andrewgond/DIY-Oscilliscope/Documentation/Oscilloscope_project_presentation.pdf

# Portable And Lightweight Oscilloscope

# Group 6: Andrew Gondoputro, Luka Radovic, Gavin Le

# Project Summary

- Designed a portable, dual-channel digital oscilloscope - Supports ±10 V analog inputs and 200 kHz sampling per channel - Built around a Teensy 4.1 with a fully custom analog front end (AFE) - Real-time signal display on onboard LCD (no PC required) - Single rotary encoder/button used for all user interaction (pause, trigger, scale) - Main goals: Low-cost, portable, standalone oscilloscope for student/lab use - Challenges included: - Conditioning ±10 V signals to 0–3.3 V ADC range - Achieving stable ADC performance - Integrating all blocks into a clean enclosure

### Achievements: Verified performance, clean interface

# Analog Front End

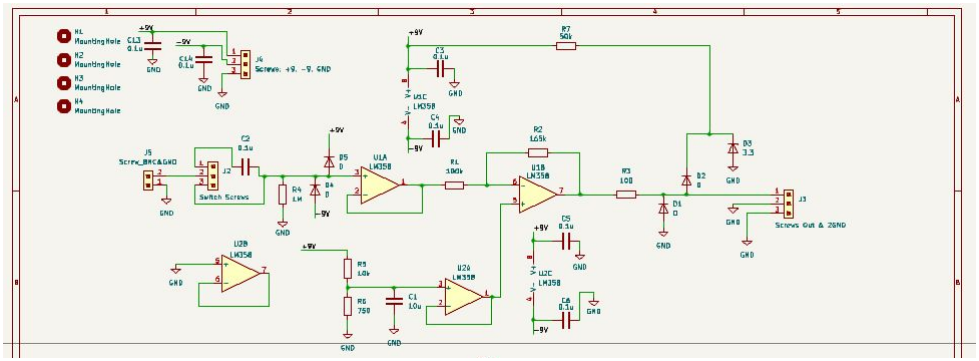
[picture p1: figure]

# Power Block/Supply and User Interface/Display

## Gavin Le

# Power Block/Supply

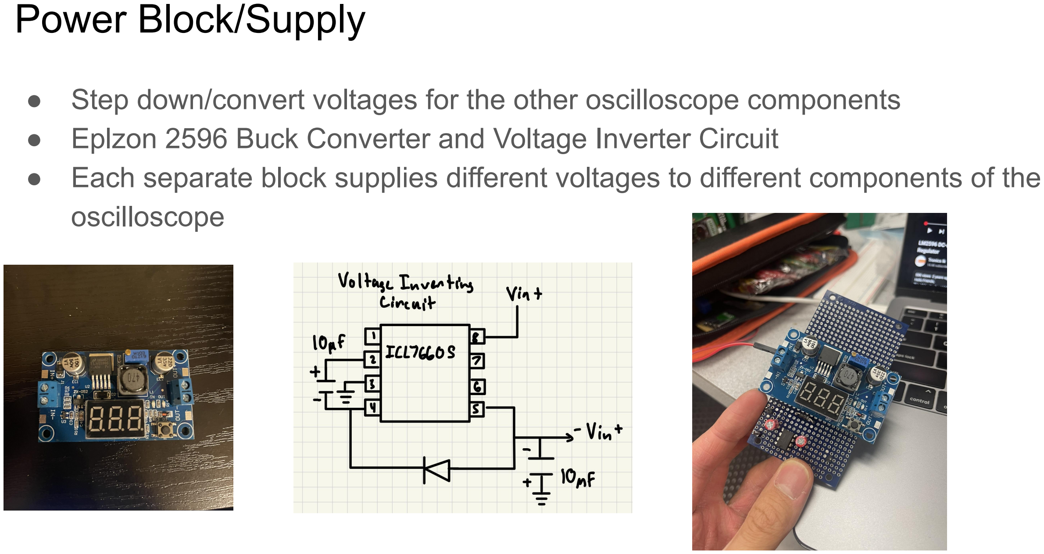
[picture p2: page 5]

## - Step down/convert voltages for the other oscilloscope components - Eplzon 2596 Buck Converter and Voltage Inverter Circuit - Each separate block supplies different voltages to different components of the oscilloscope

# Diagram

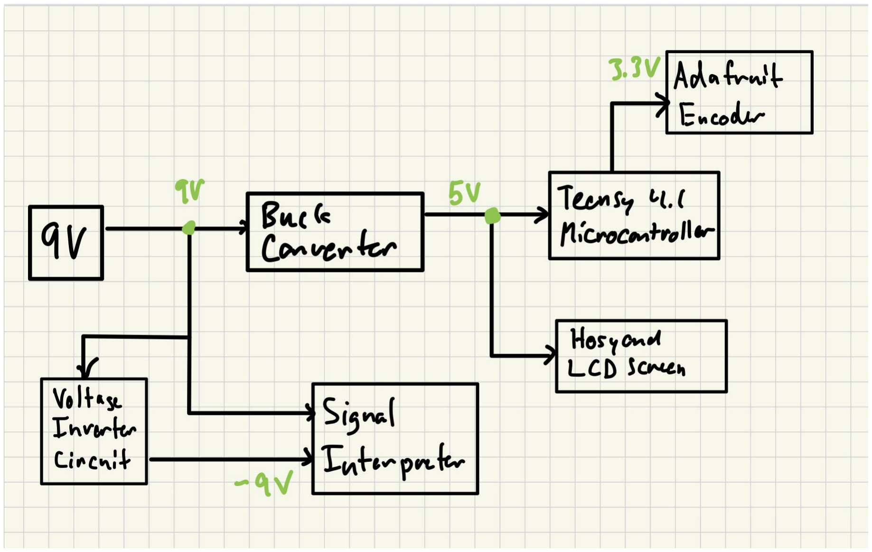
[picture p3: figure]

# User Interface/Display

## - One Adafruit I2C Stemma QT Rotary Encoder

- Acts as button and knob
- Allows for switching between channels, axes, selecting/triggering, and sweeping signals

## - Hosyond IPS Capacitive Touch Screen LCD Module

- Displays time and voltage axes, as well as electric signal

## - Teensy 4.1 Microcontroller

- Handles the code and functions of the oscilloscope
- Acts as an interface bridge between the encoder and lcd screen

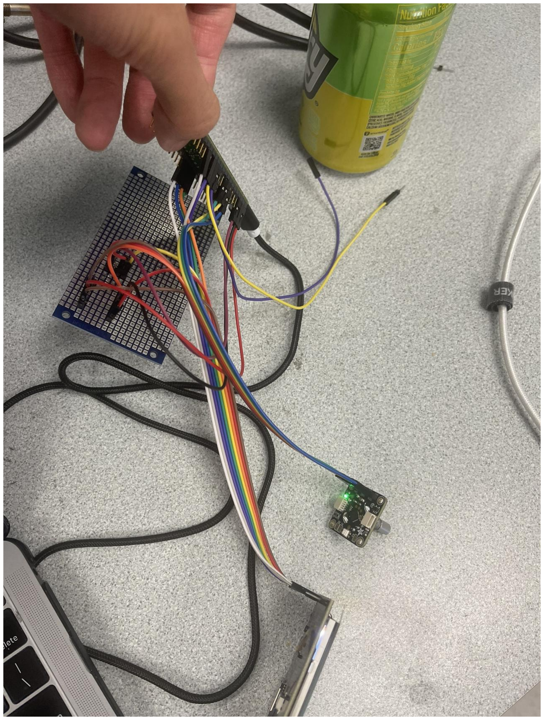
[picture p4: figure]
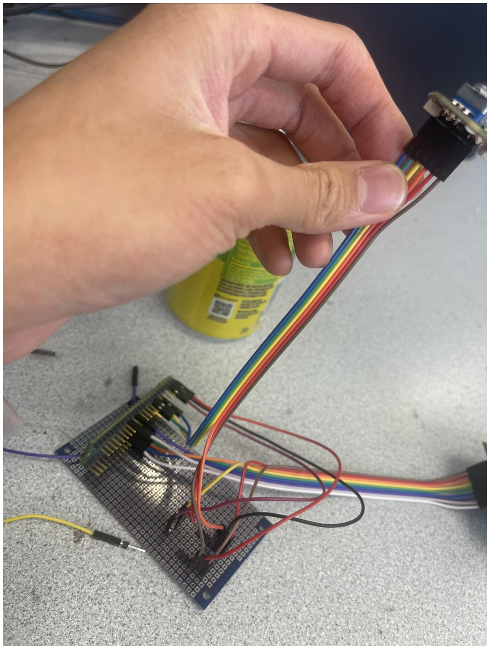
[picture p5: figure]

# Enclosure

## - Made in CAD for exact measurements -> 3D Printed in PLA Plastic - Sizing of: 3.5 x 4.5 x 7.5in - Slots for each UI component to fit properly either through tolerances or screws - Interior holding all other blocks with proper placement

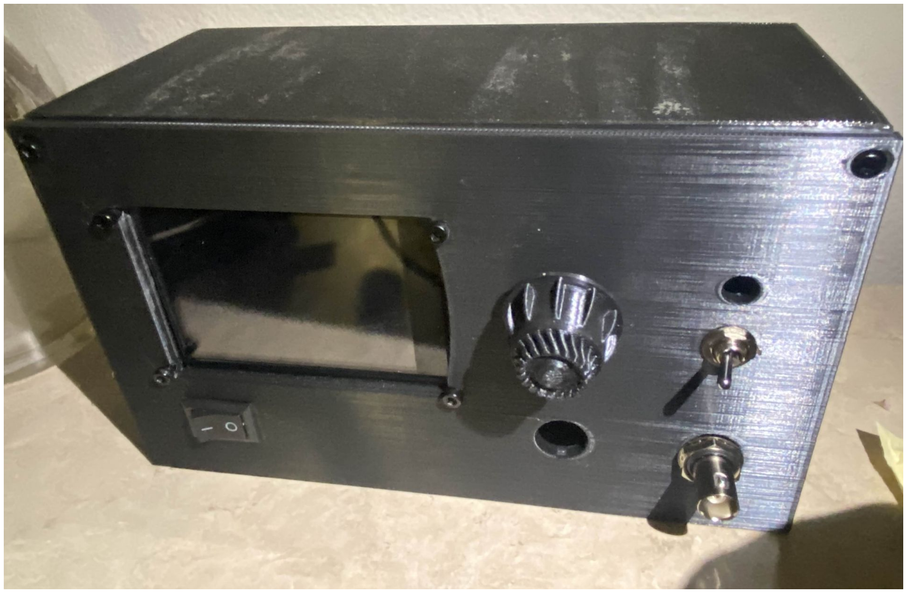
[picture p6: figure]
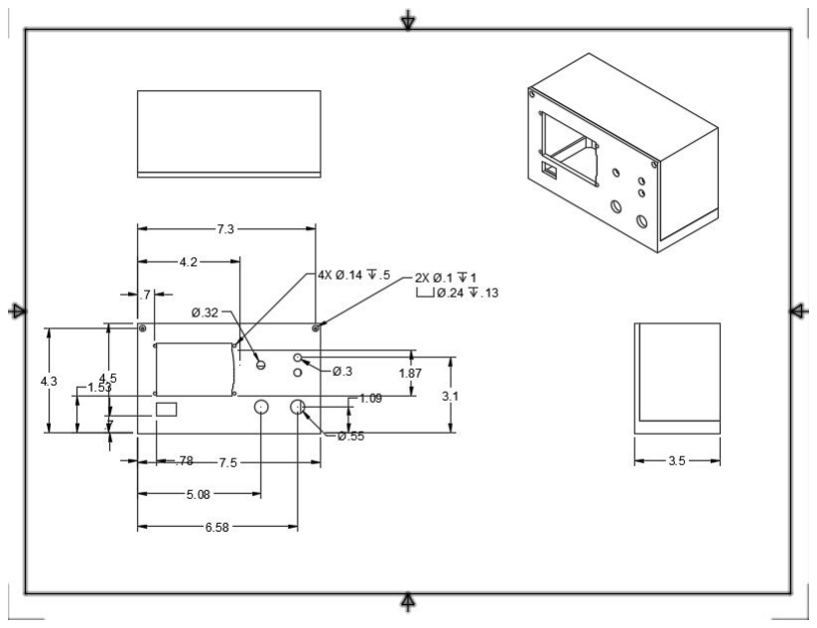
[picture p7: figure]

# Bottom Piece

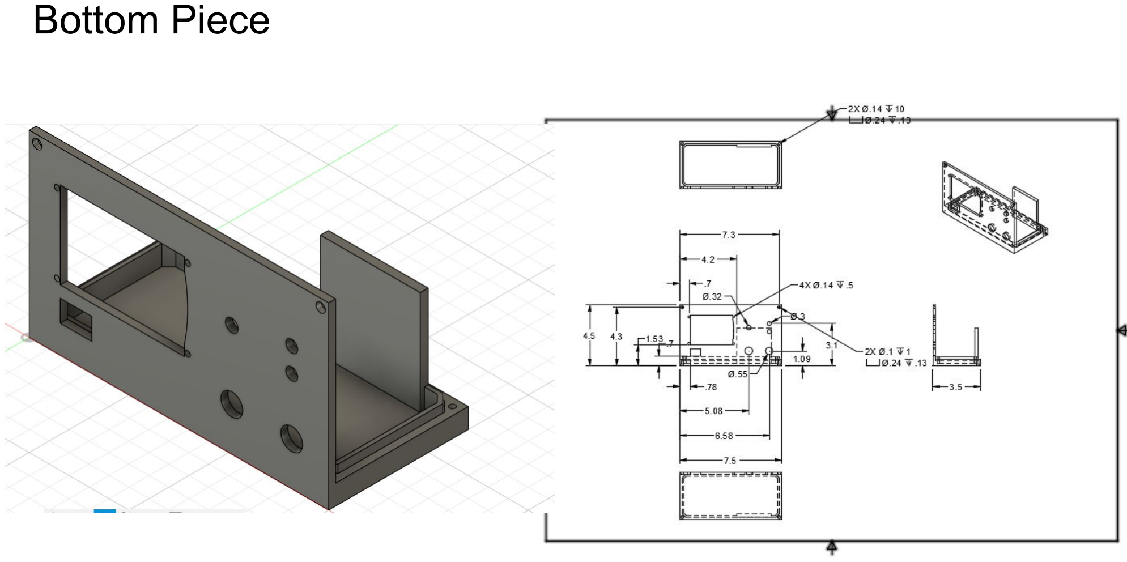
[picture p8: page 9]

# Top Piece

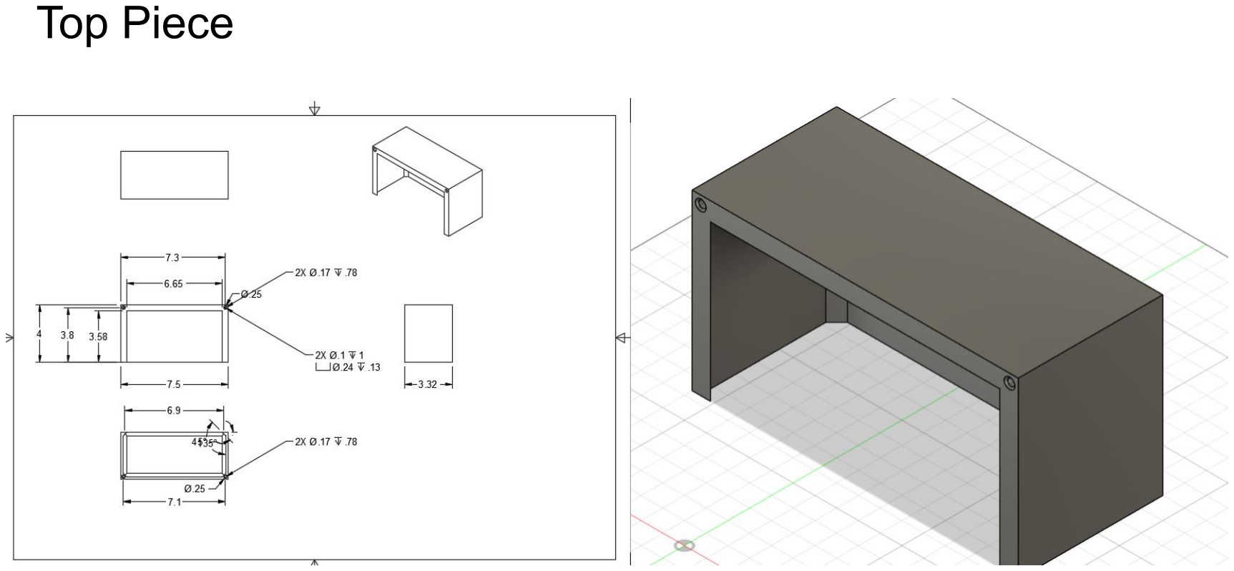
[picture p9: page 10]

# Code

## Main Parts:

## - Receiving signals from ADC to sample a high frequency

## - Receiving User Input from encoder

## - Coding a User Output on the LCD

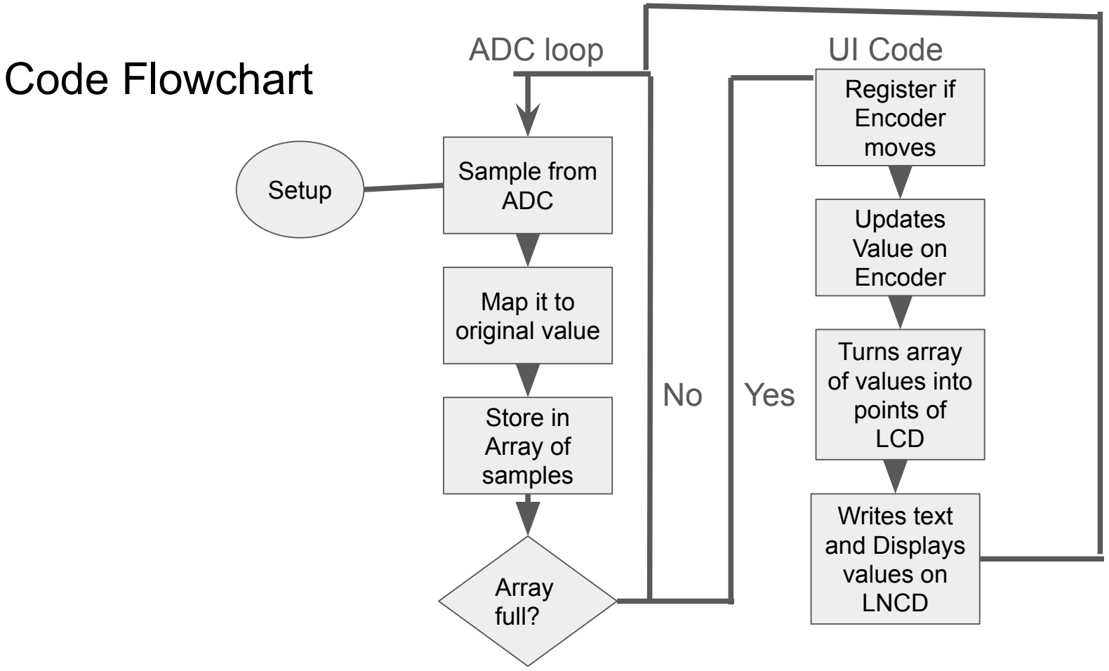
[picture p10: figure]
Code Flowchart; Setup; Sample from ADC; Map it to original value; Store in Array of samples; Array full?; ADC loop; Yes; Register if Encoder moves; Updates Value on Encoder; Turns array of values into points of LCD; Writes text and Displays values on LNCD; UI Code

# Code: Sampling

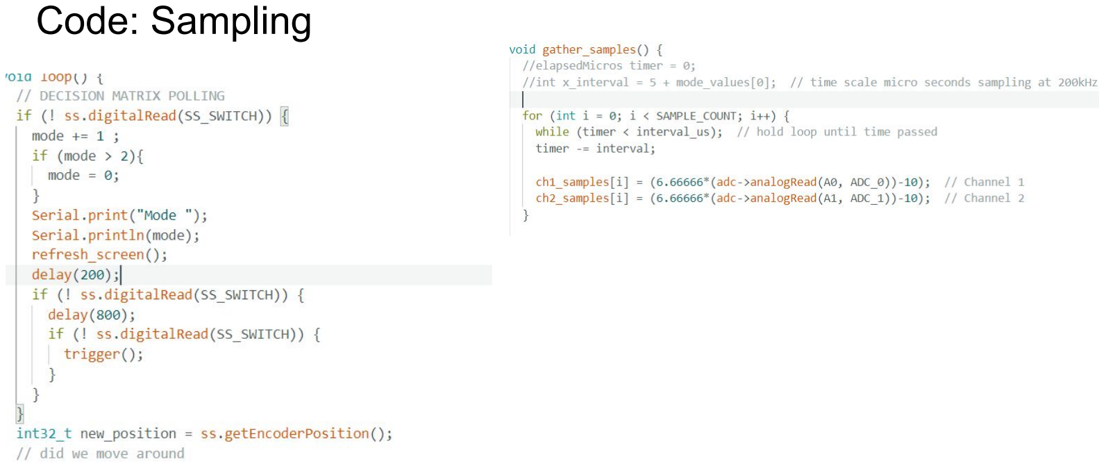
[picture p11: page 13]

# Code: User Input

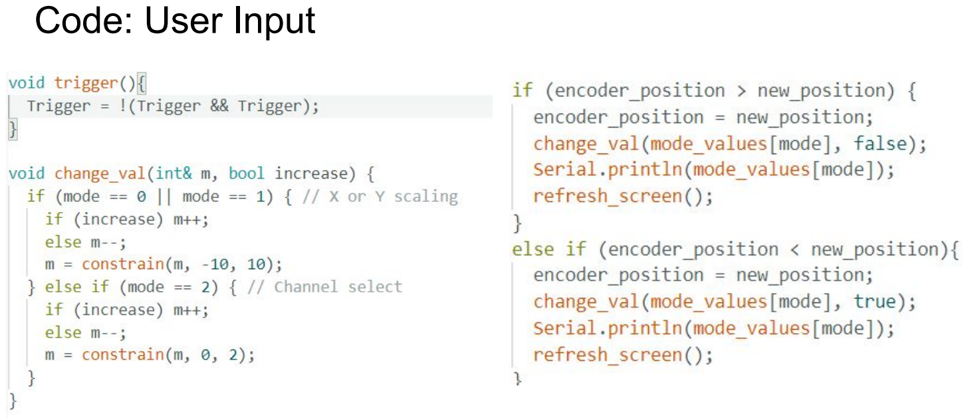
[picture p12: page 14]

# Code: User Output

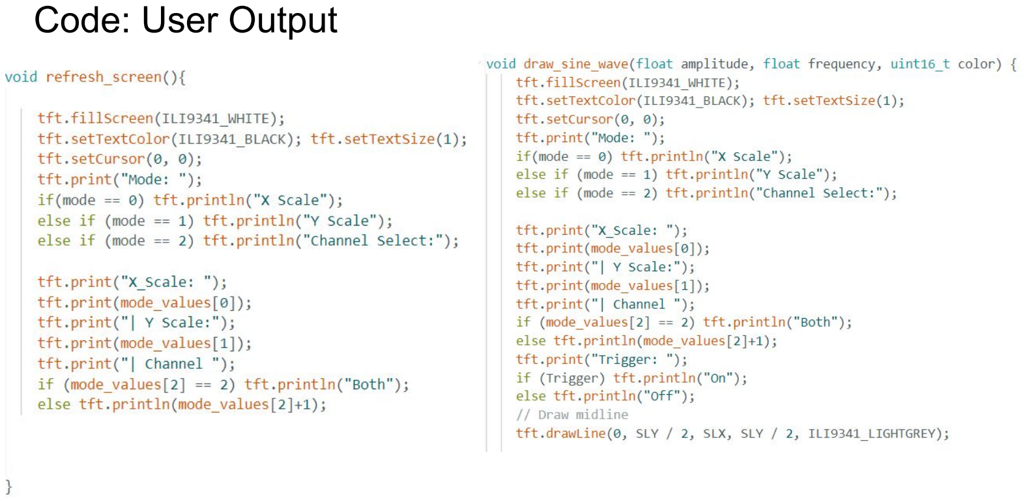
[picture p13: page 15]

# Closing

Achieved:

- Safe ±10 V input range
- 200 kHz sampling per channel
- Real-time LCD display with intuitive control
- Fully modular and battery-powered design

Built completely from scratch with protoboards, firmware, and 3D printing Future improvements:

- Custom PCB for better layout and durability
- Higher-resolution display or waveform features (e.g., FFT mode)
- Expansion to 4+ channels or wireless display integration

Demonstrated that lab-grade tools can be made compact, affordable, and user-friendly
