andrewgond/DIY-Oscilliscope/Osilloscope-BOM.pdf

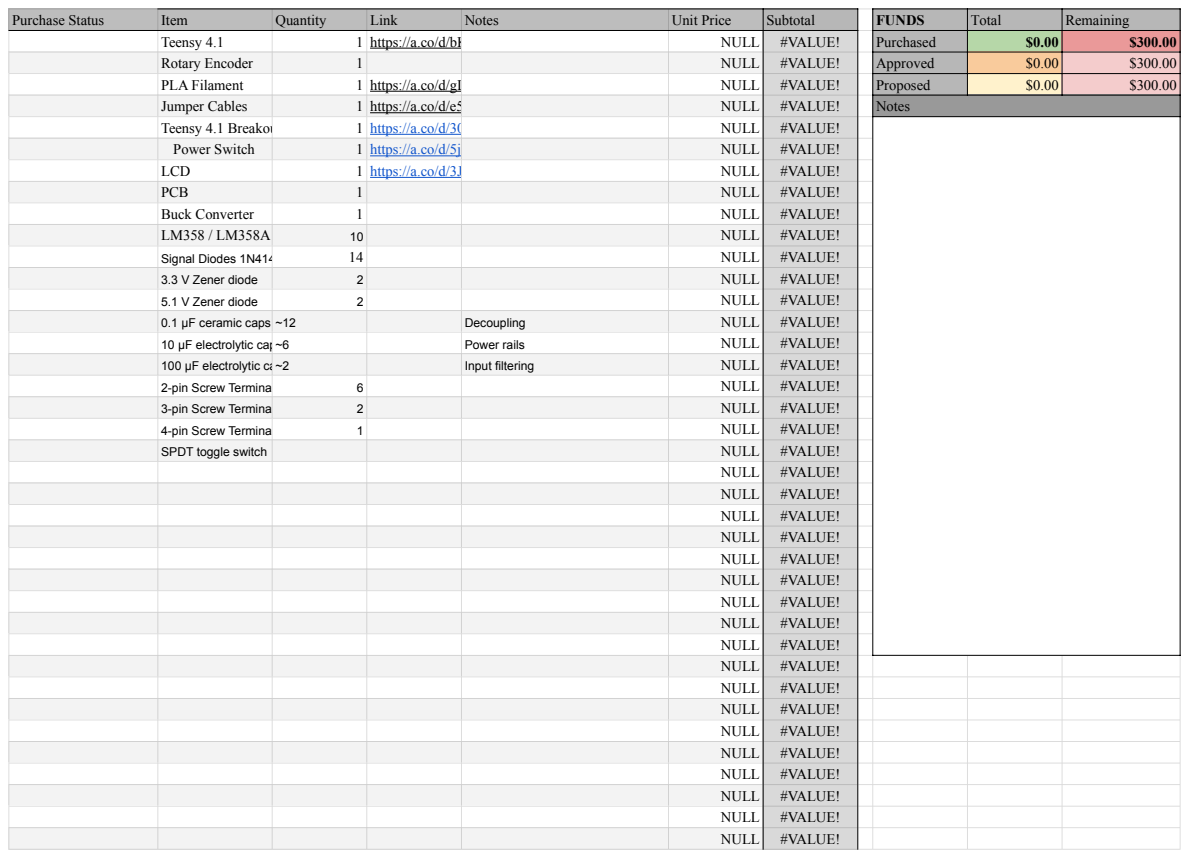
[picture p14: page 1]
Purchase Status; Item; Quantity; Link; Notes; Unit Price; Subtotal; FUNDS; Total; Remaining; Teensy 4.1; 1 https://a.co/d/bKC4gqg; NULL; #VALUE!; Purchased; Rotary Encoder; Approved; PLA Filament; 1 https://a.co/d/gLLok2z; Proposed; Jumper Cables; 1 https://a.co/d/e5Bf7xR; Teensy 4.1 Breakout Board; 1 https://a.co/d/30mFnx3; Power Switch; 1 https://a.co/d/5jJEjIV; LCD; 1 https://a.co/d/3JnT9iV; PCB; Buck Converter; LM358 / LM358A / LM358B dual op-amp 10; Signal Diodes 1N4148; 3.3 V Zener diode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

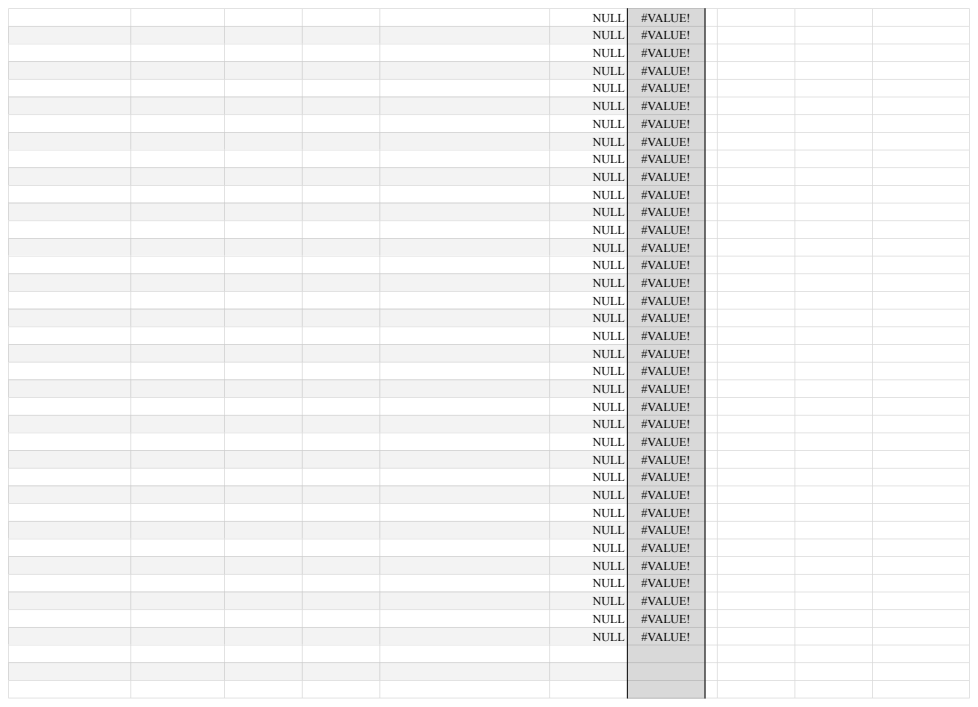
[picture p15: page 2]

NULL | #VALUE!

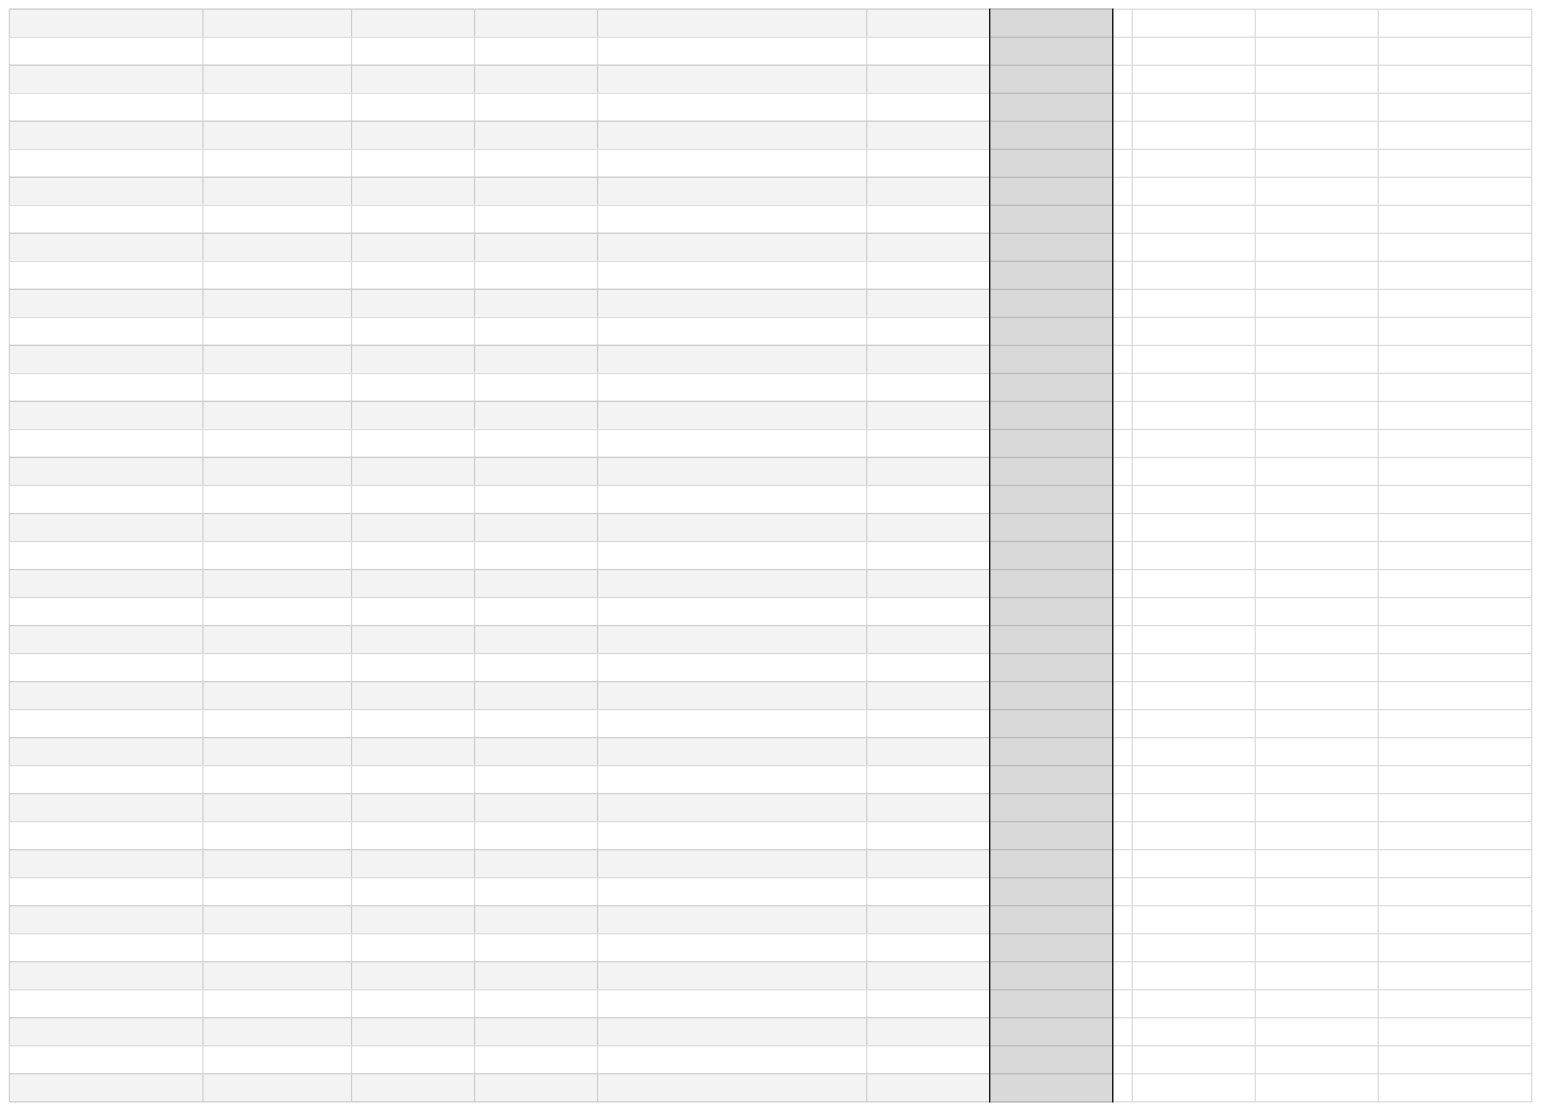
[picture p16: page 3]

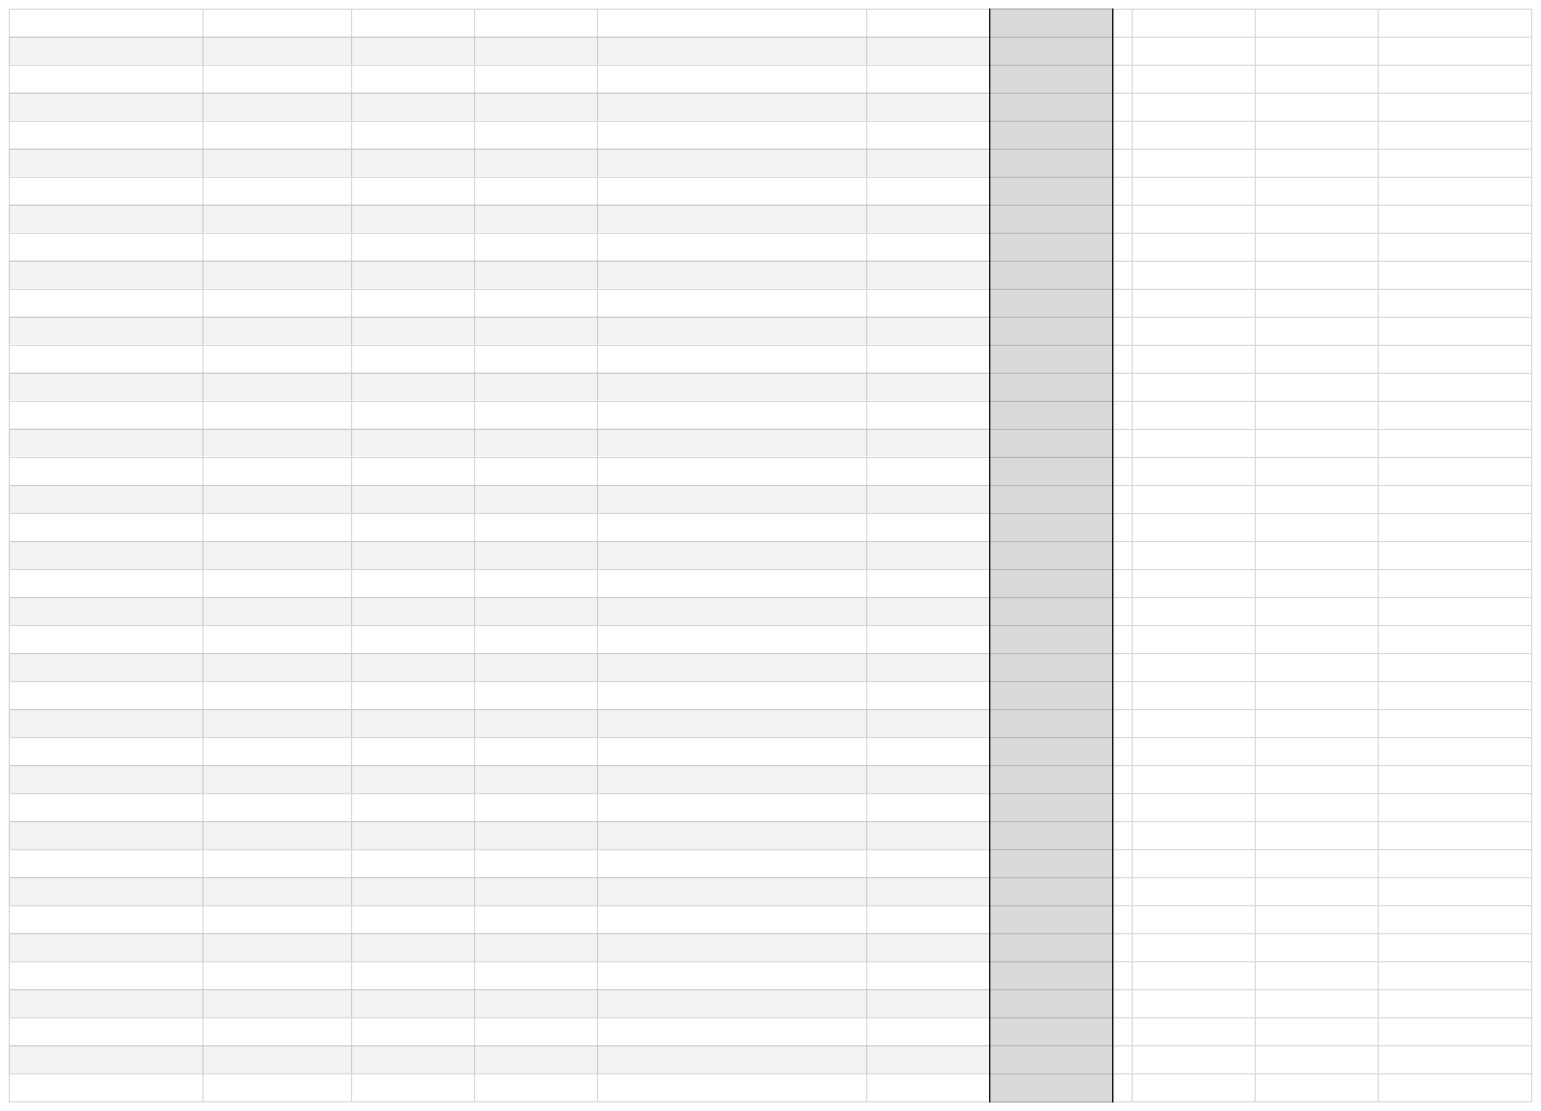
[picture p17: page 4]

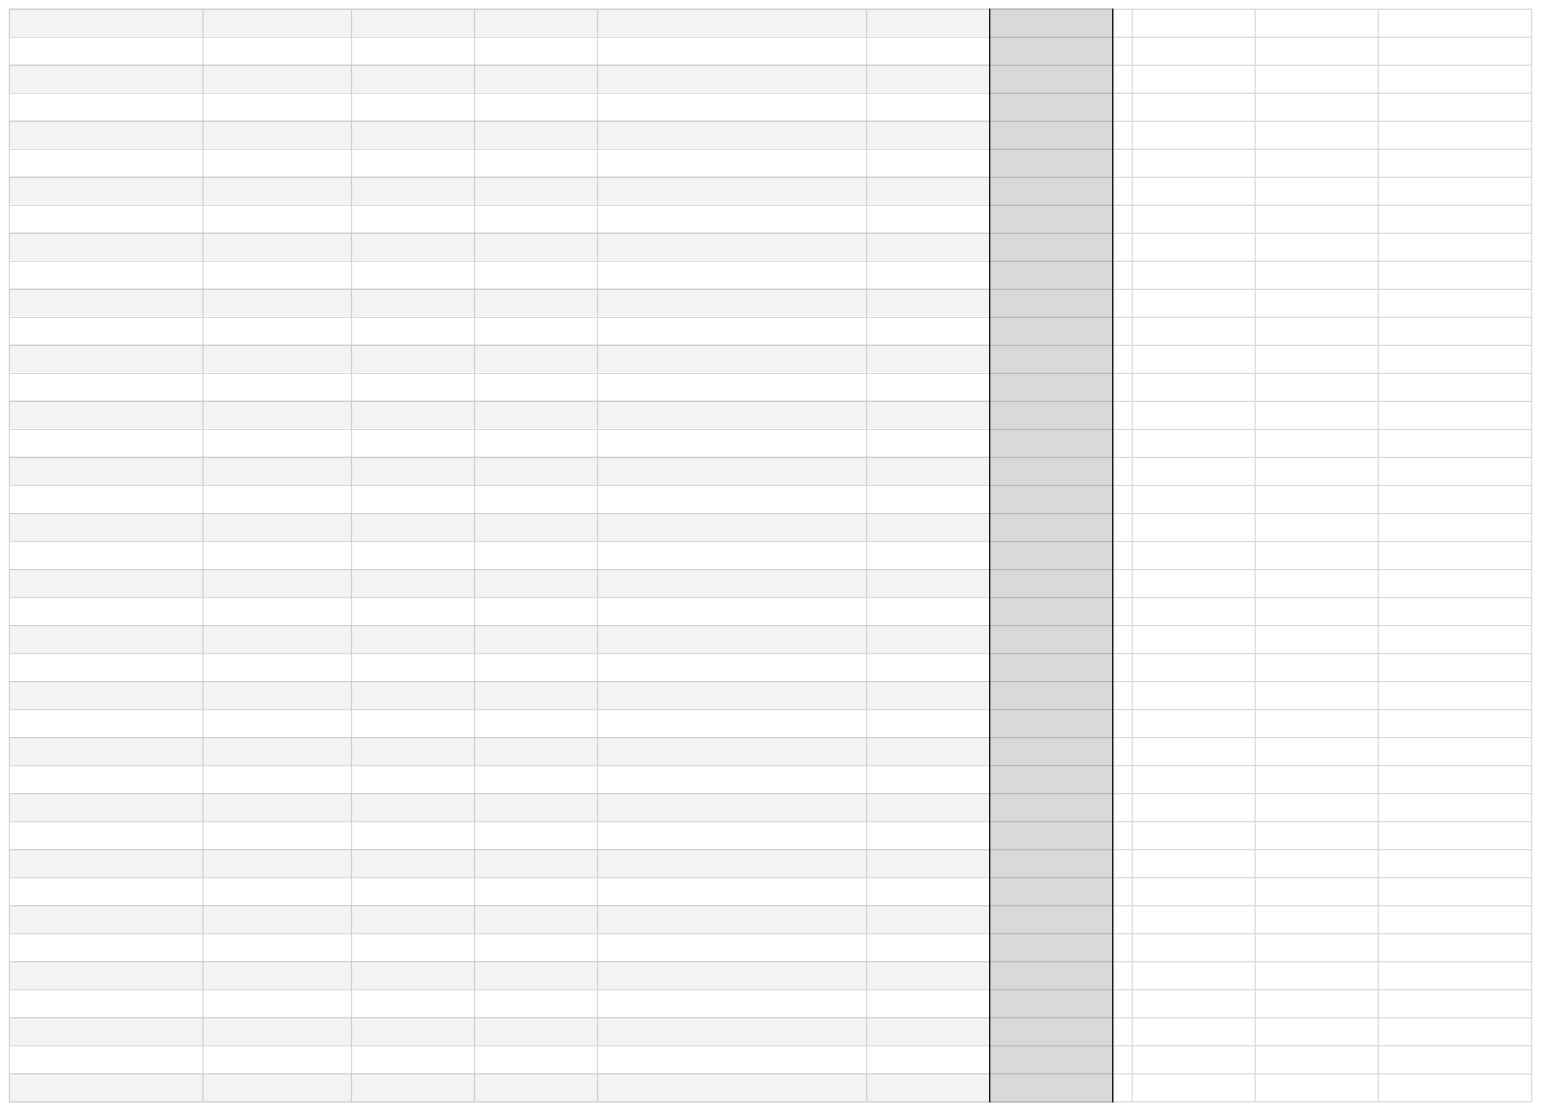
[picture p18: page 9]

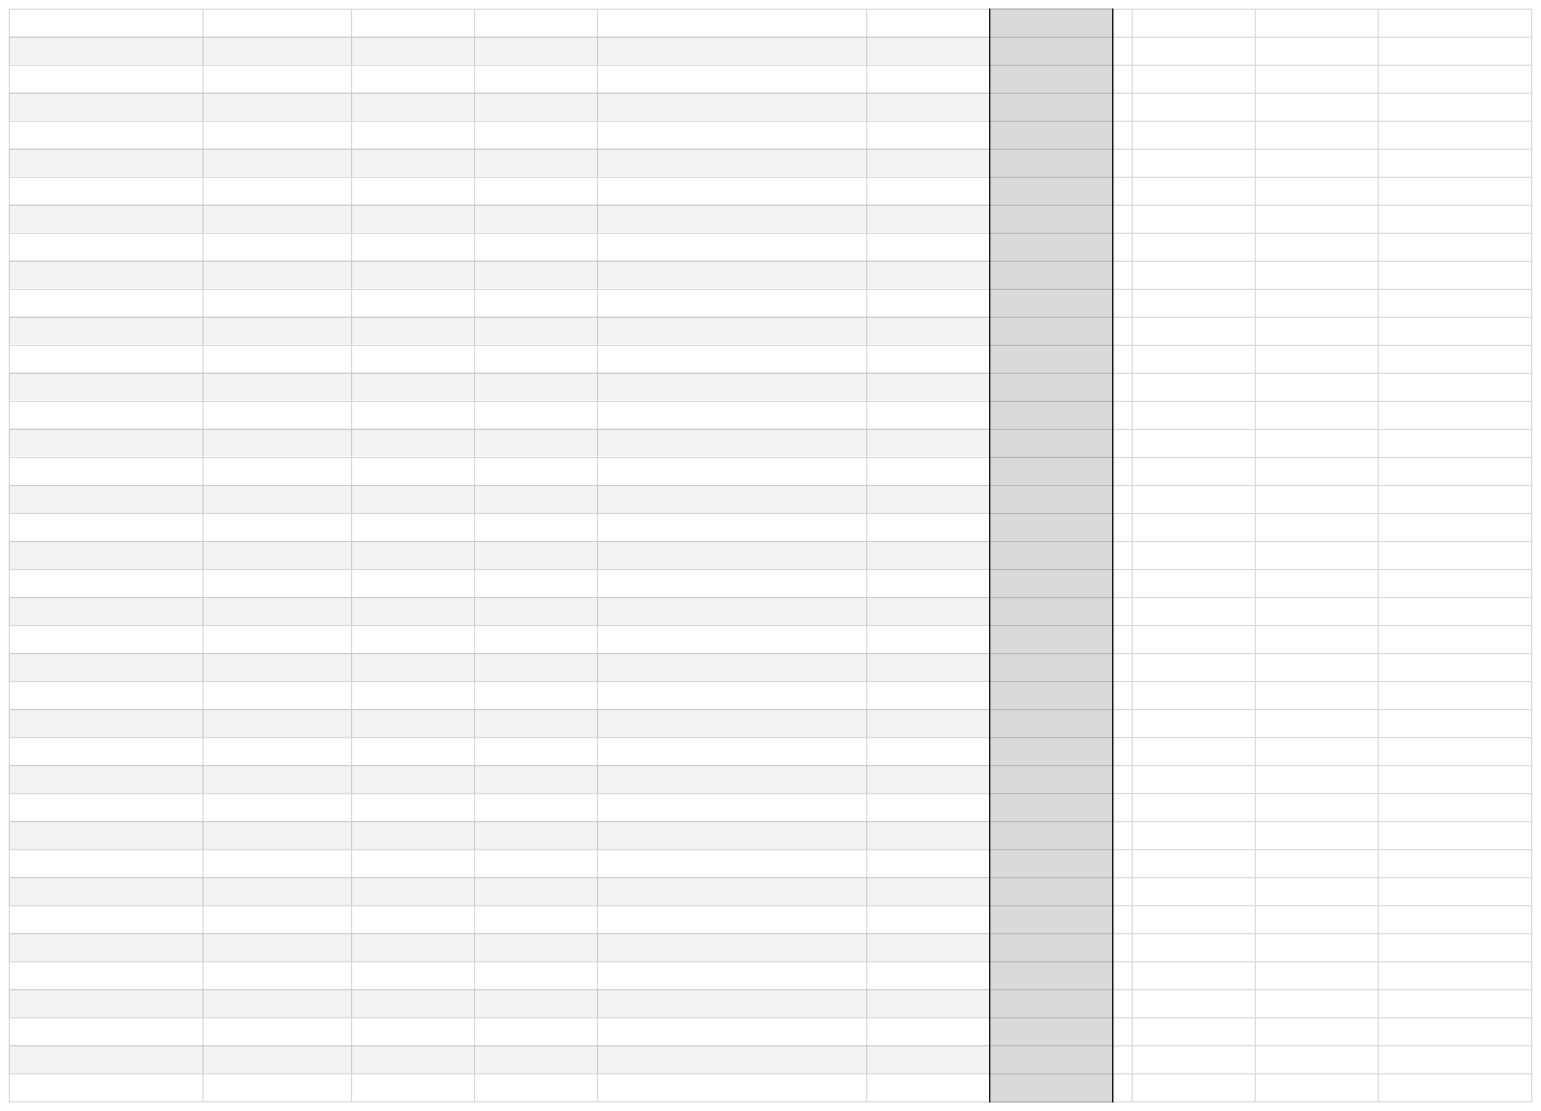
[picture p19: page 10]

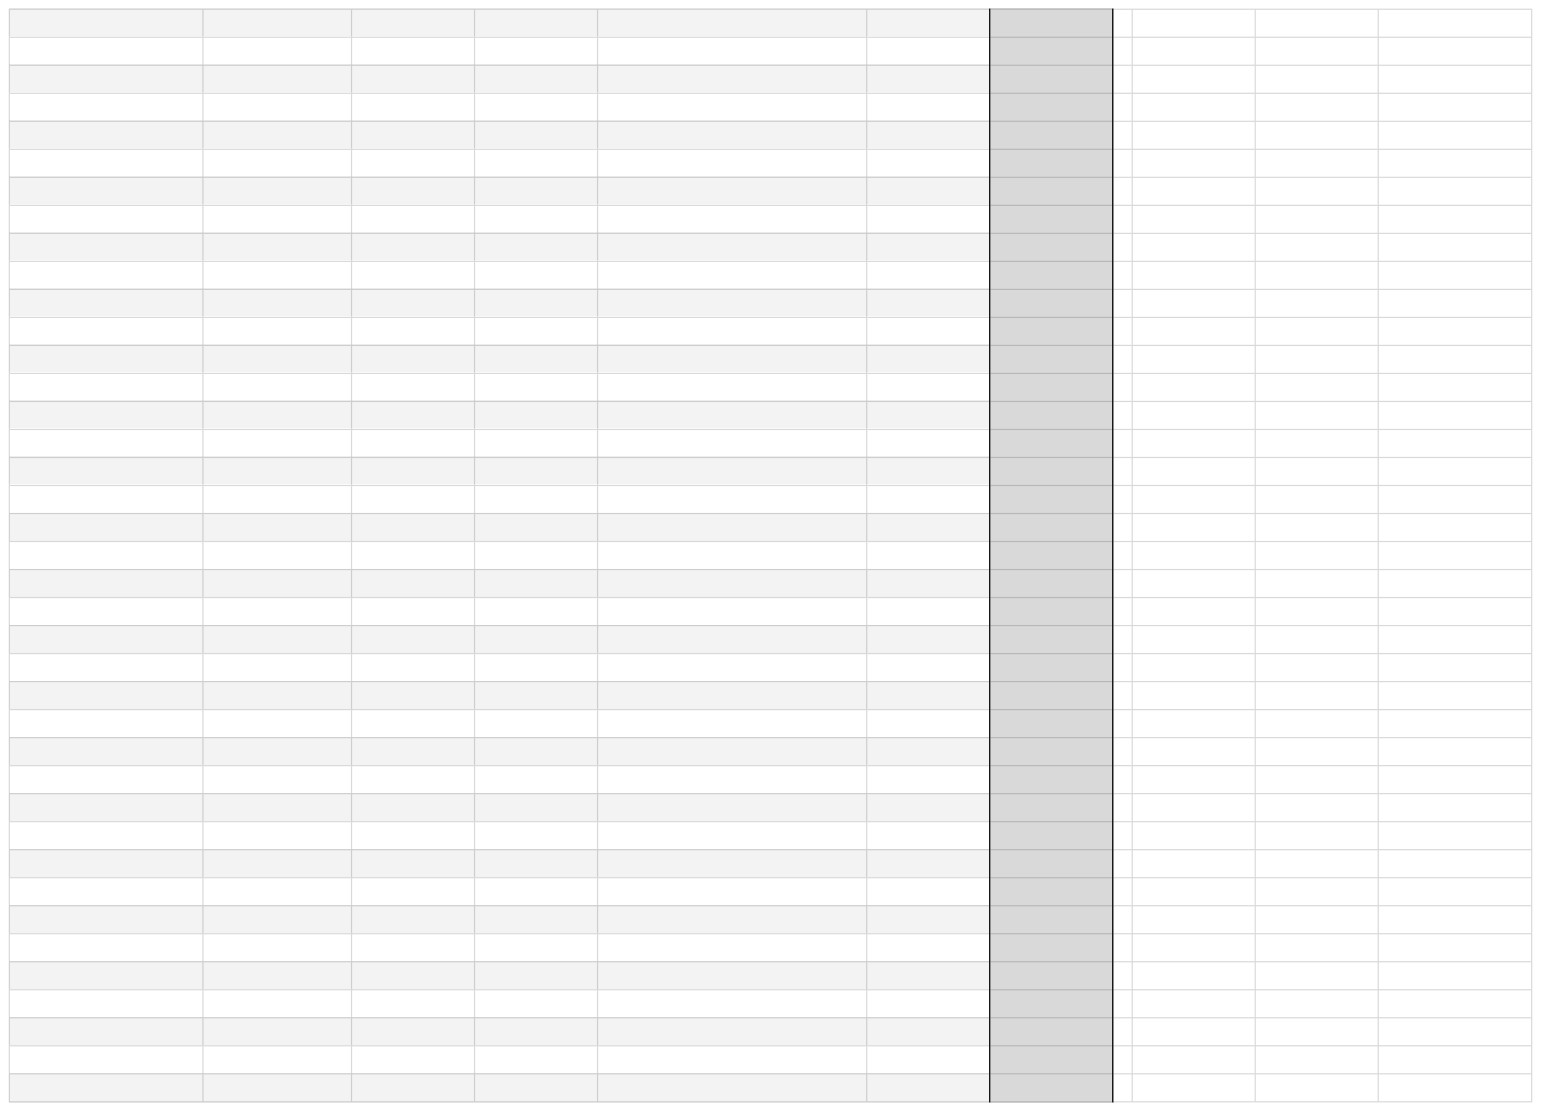
[picture p20: page 11]

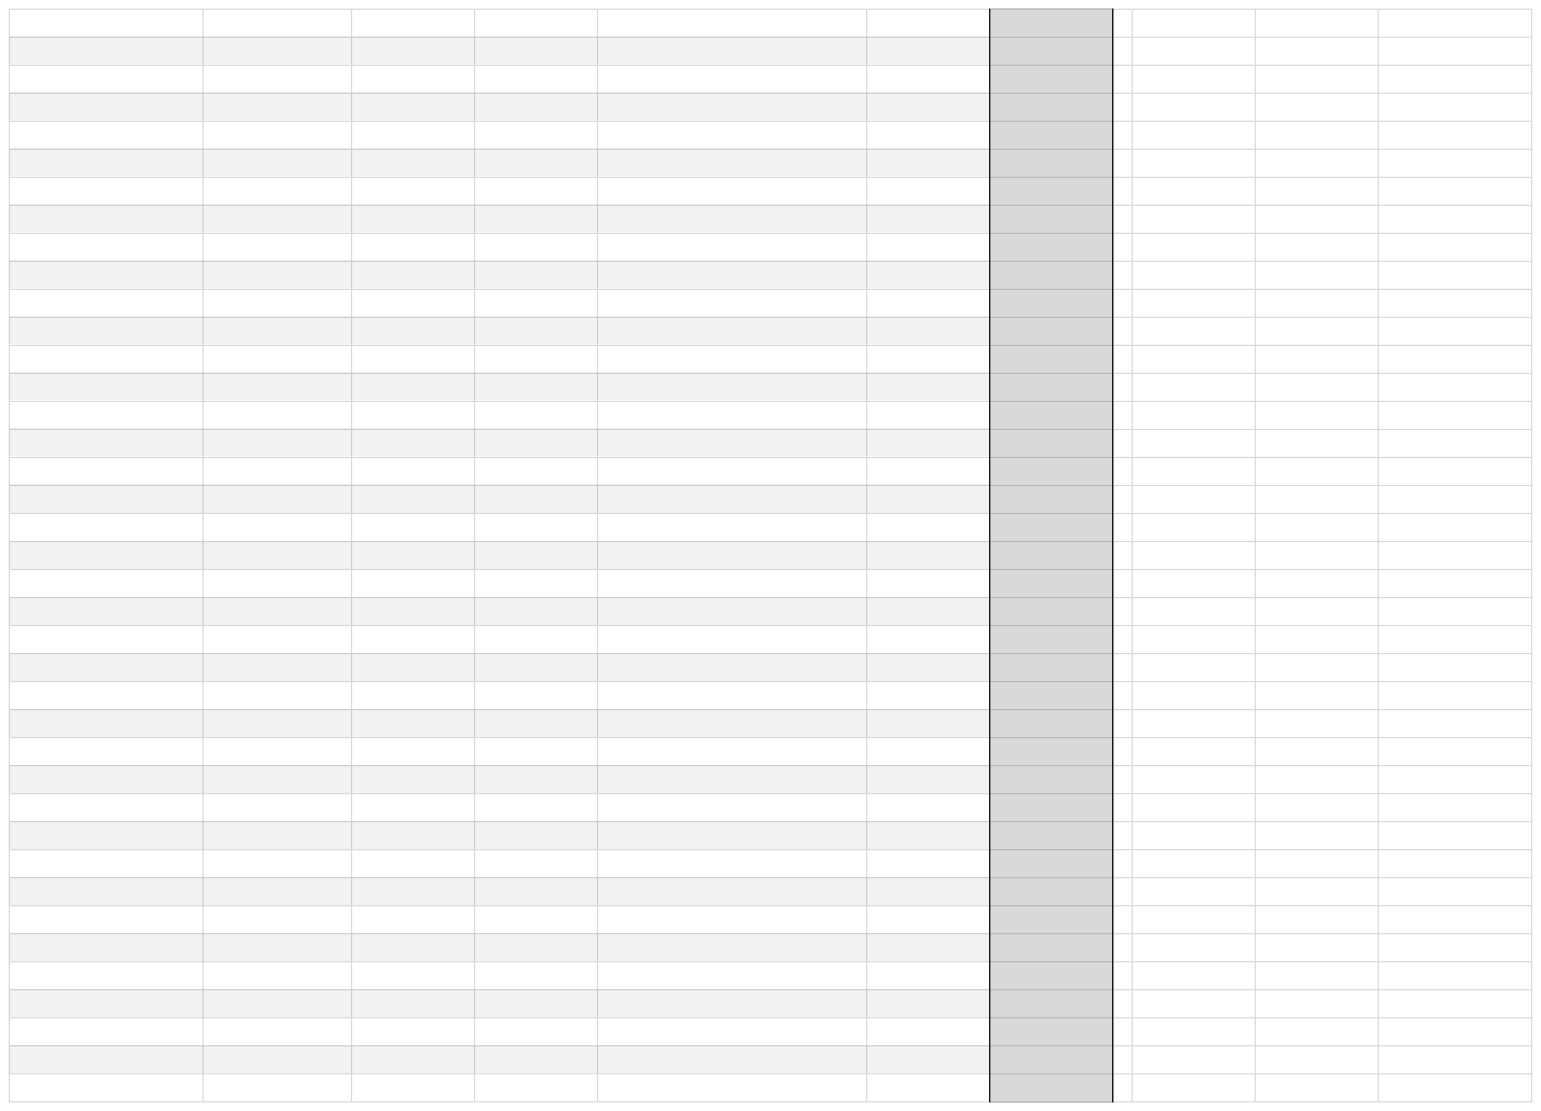
[picture p21: page 12]

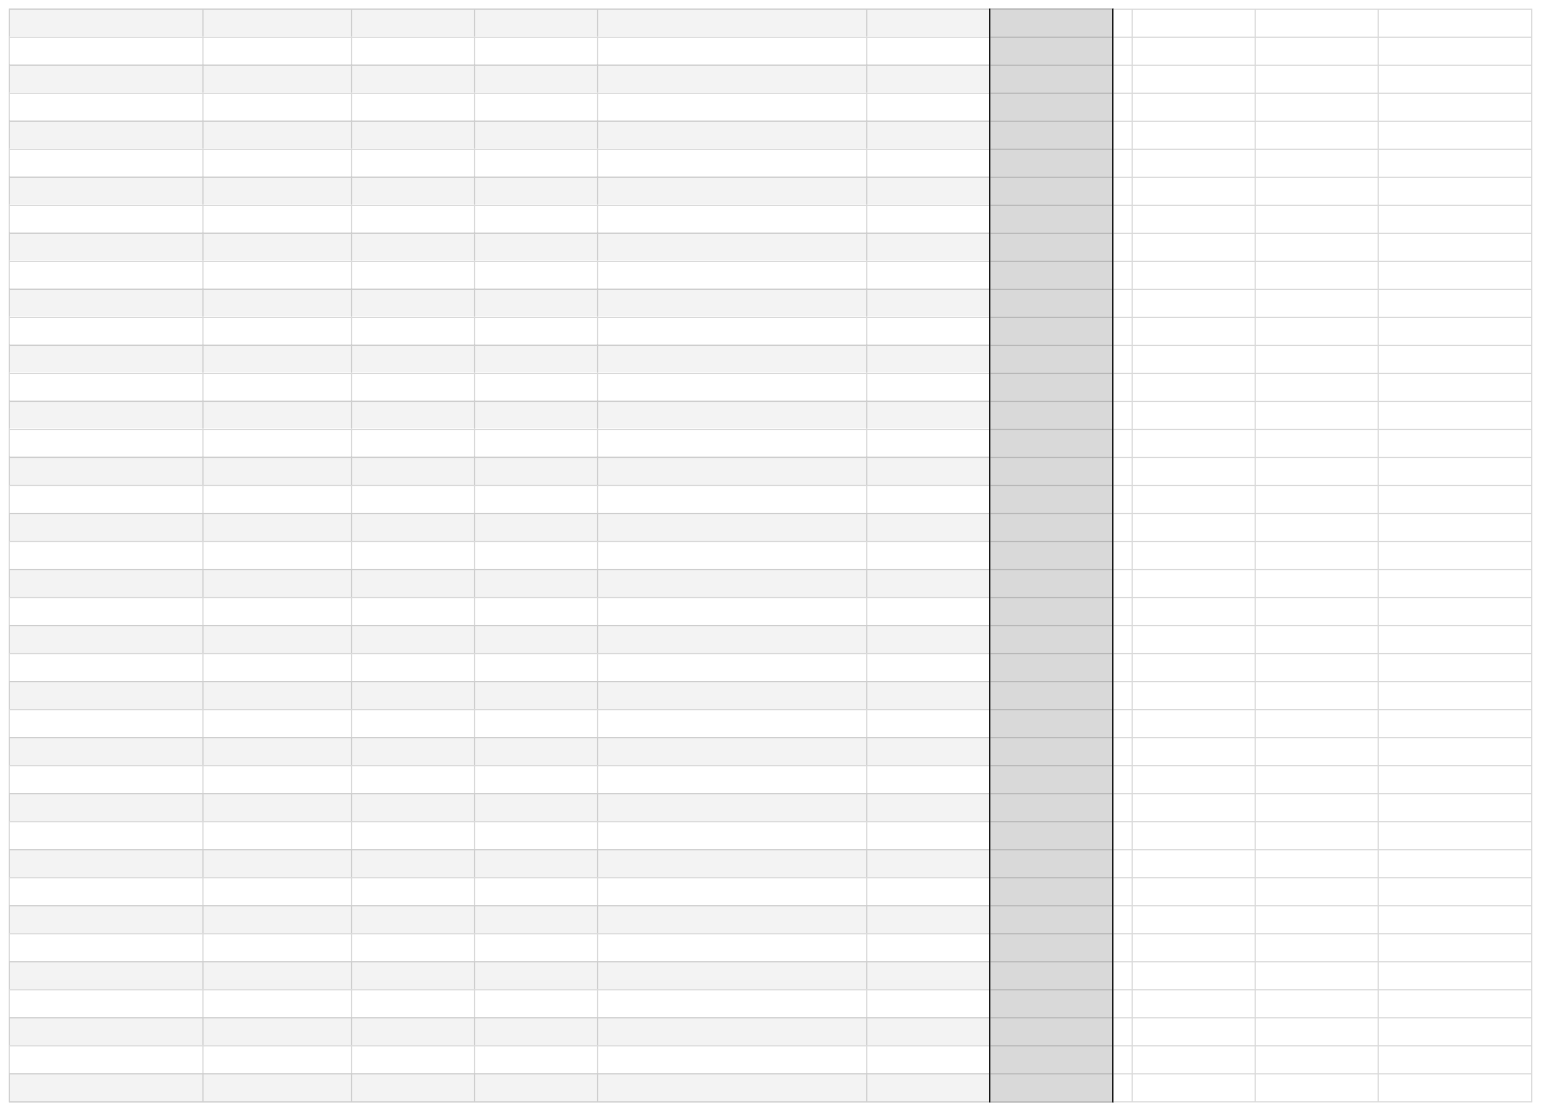
[picture p22: page 13]

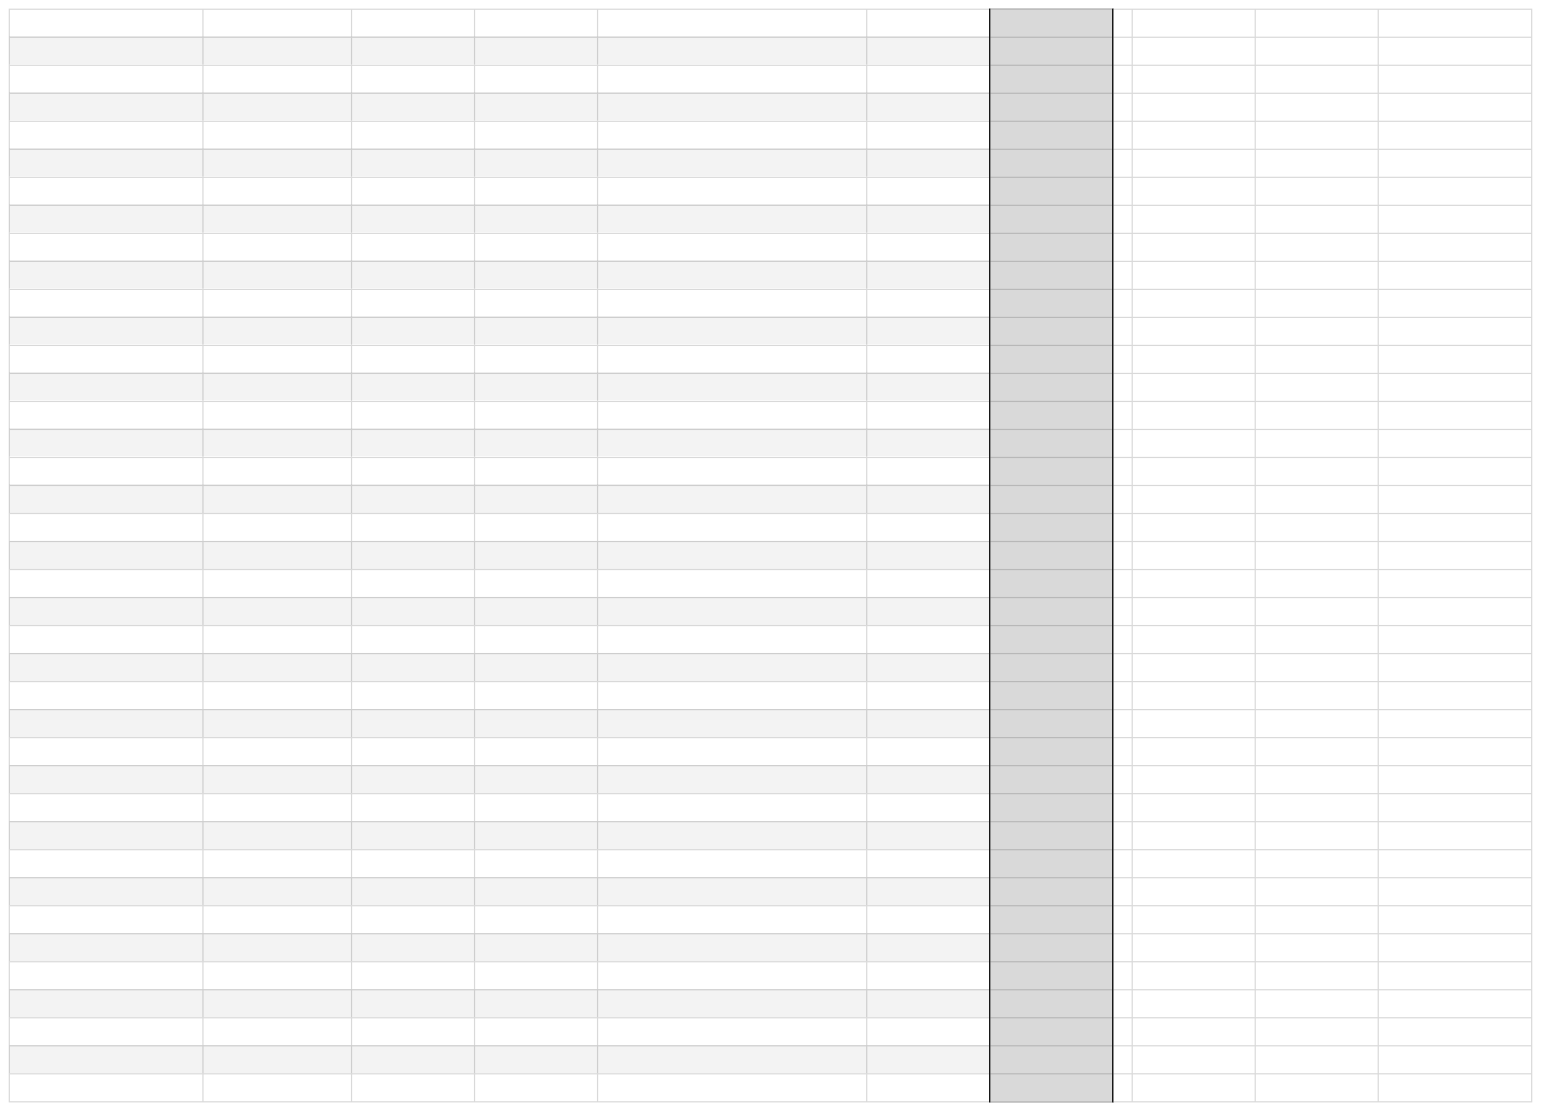
[picture p23: page 14]

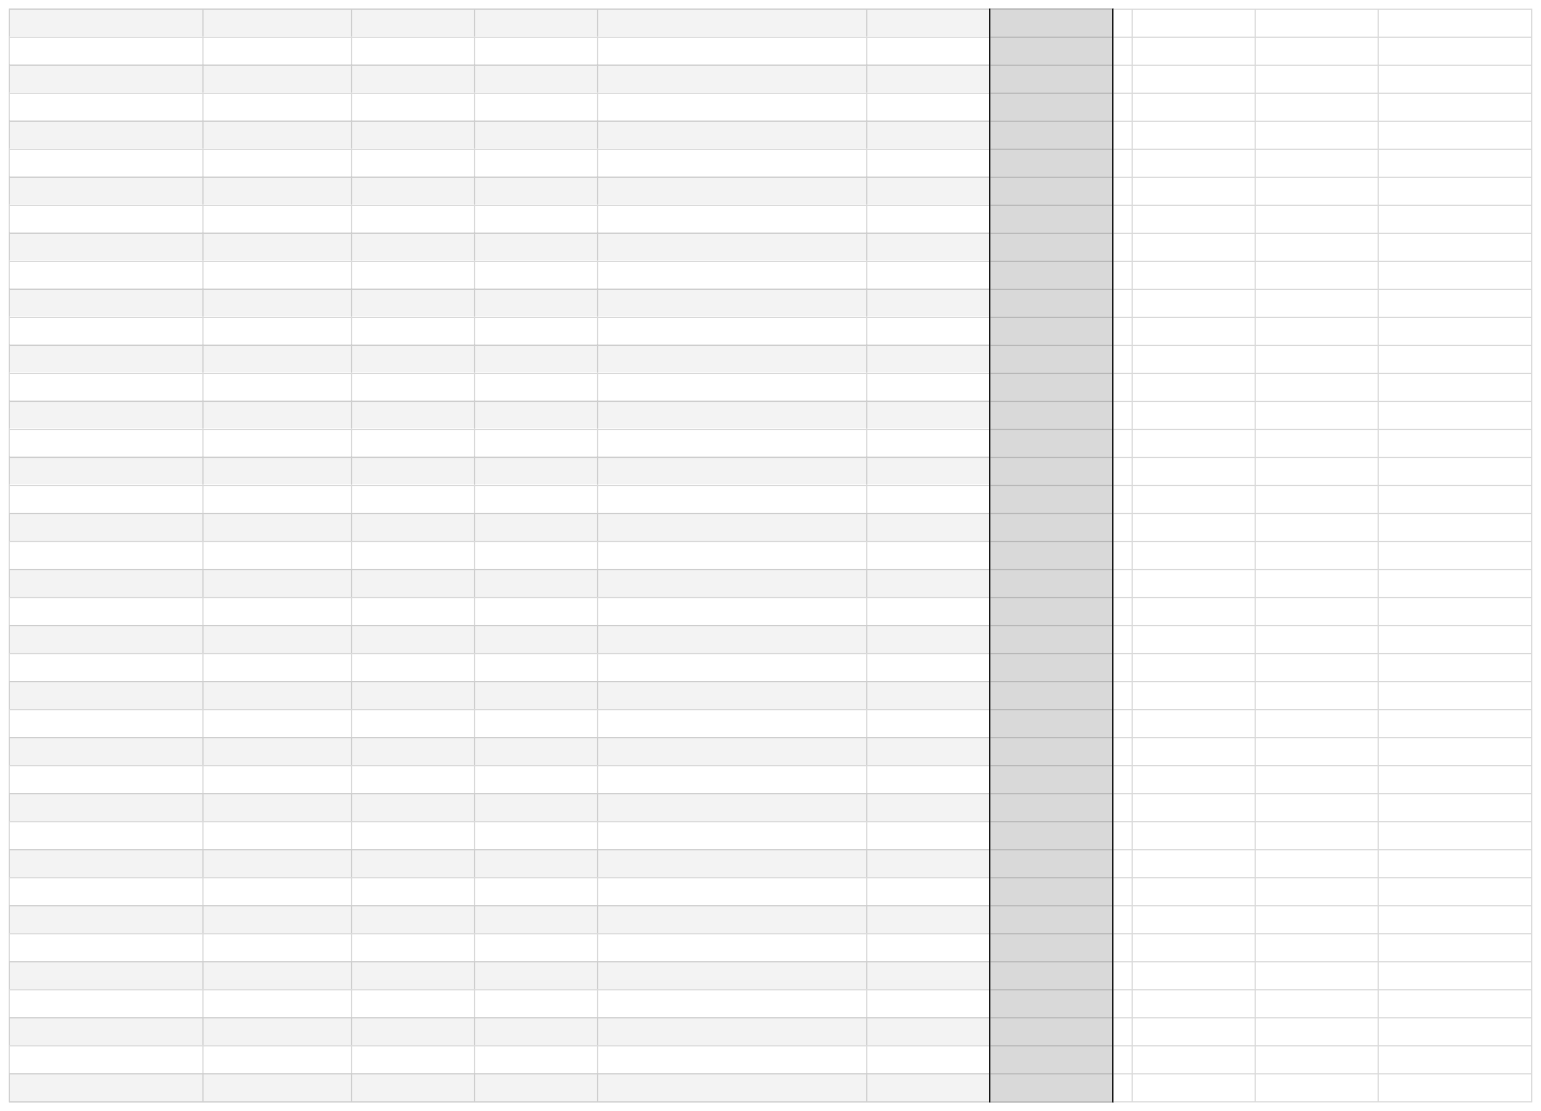
[picture p24: page 15]

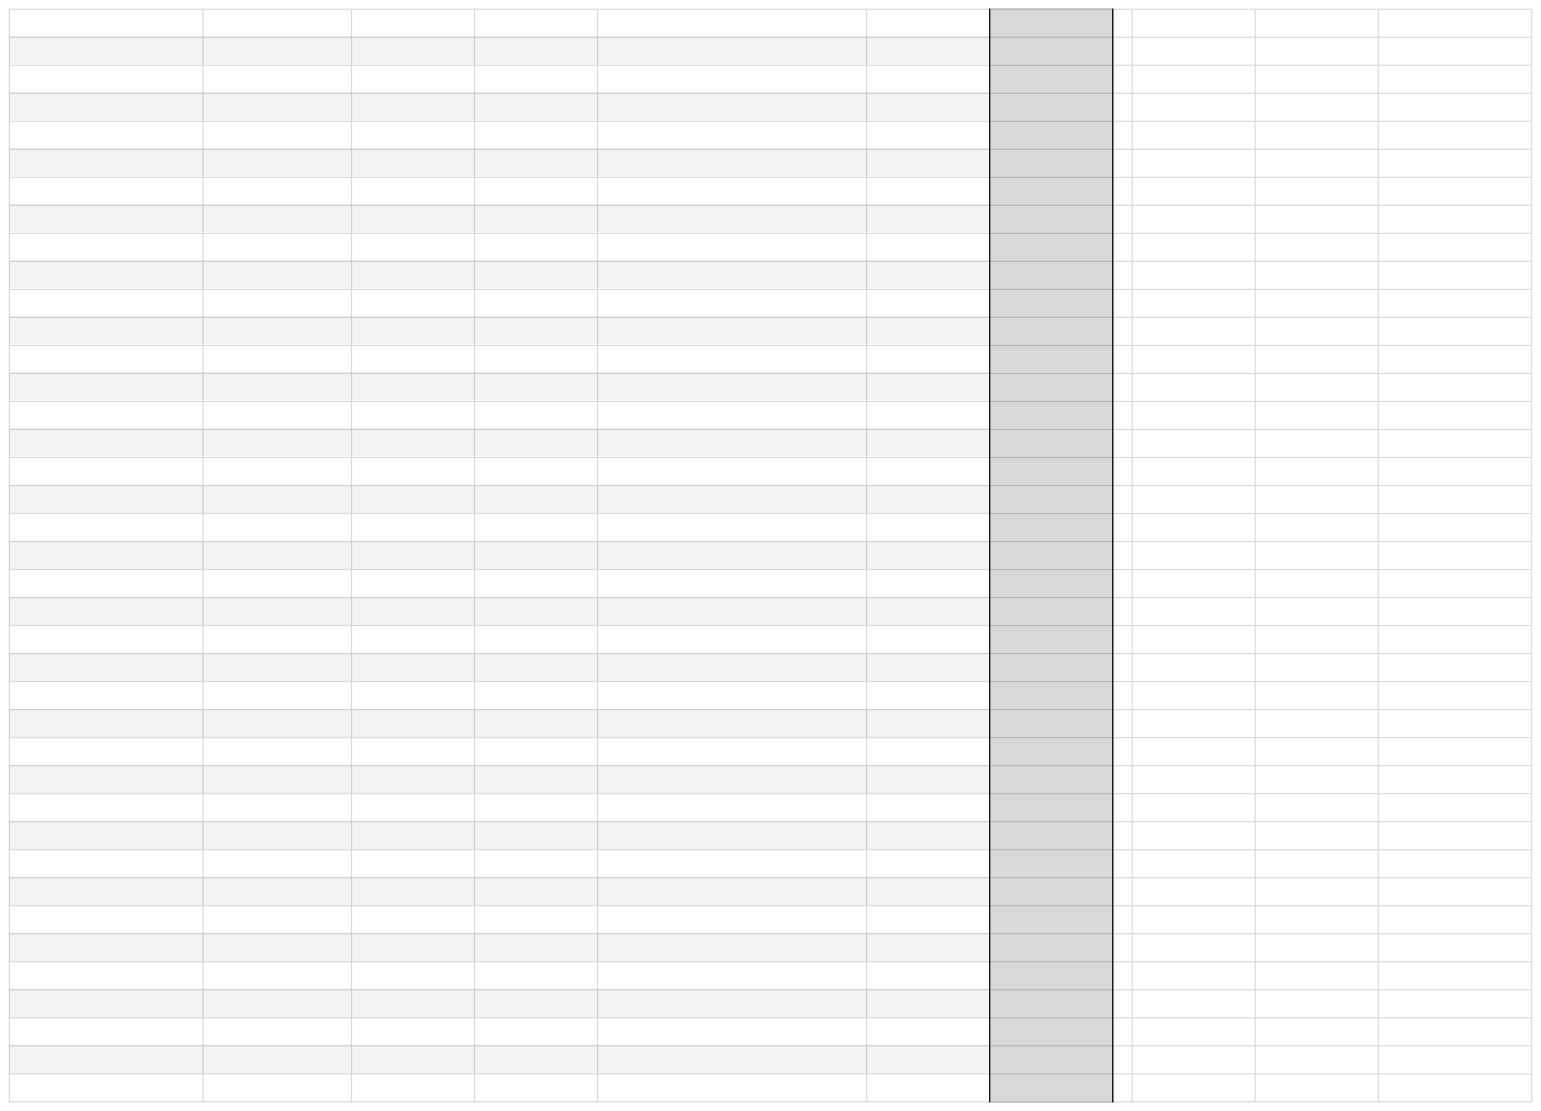
[picture p25: page 16]

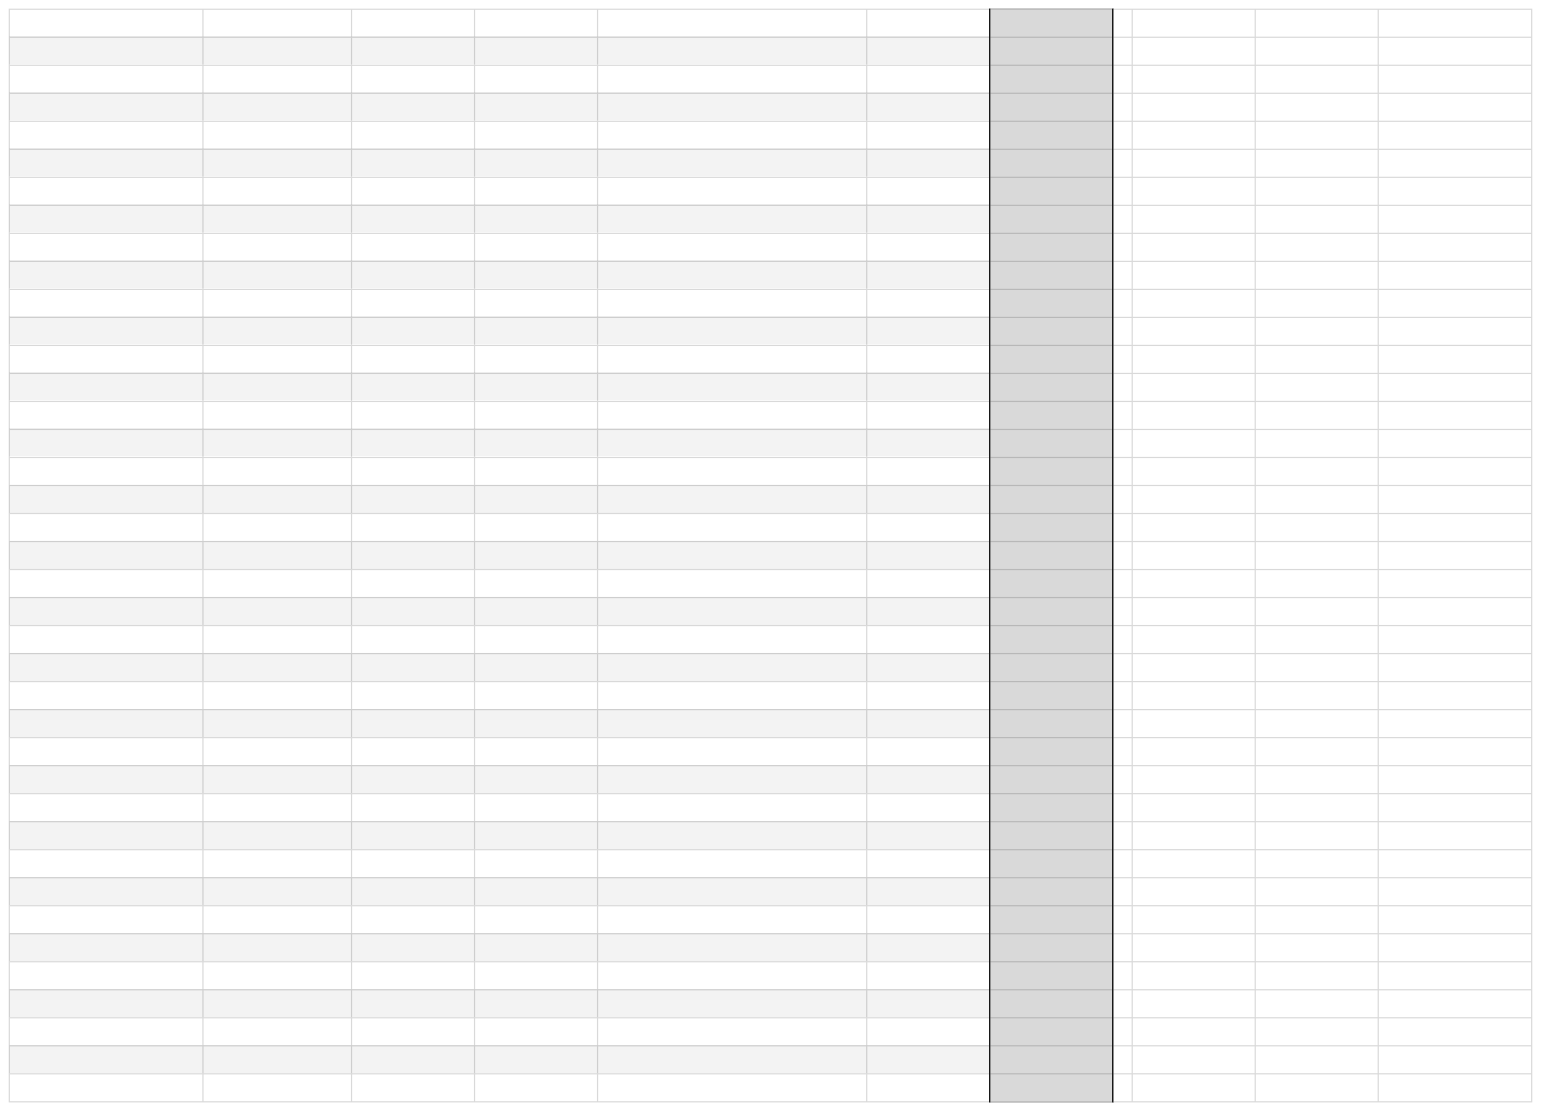
[picture p26: page 18]

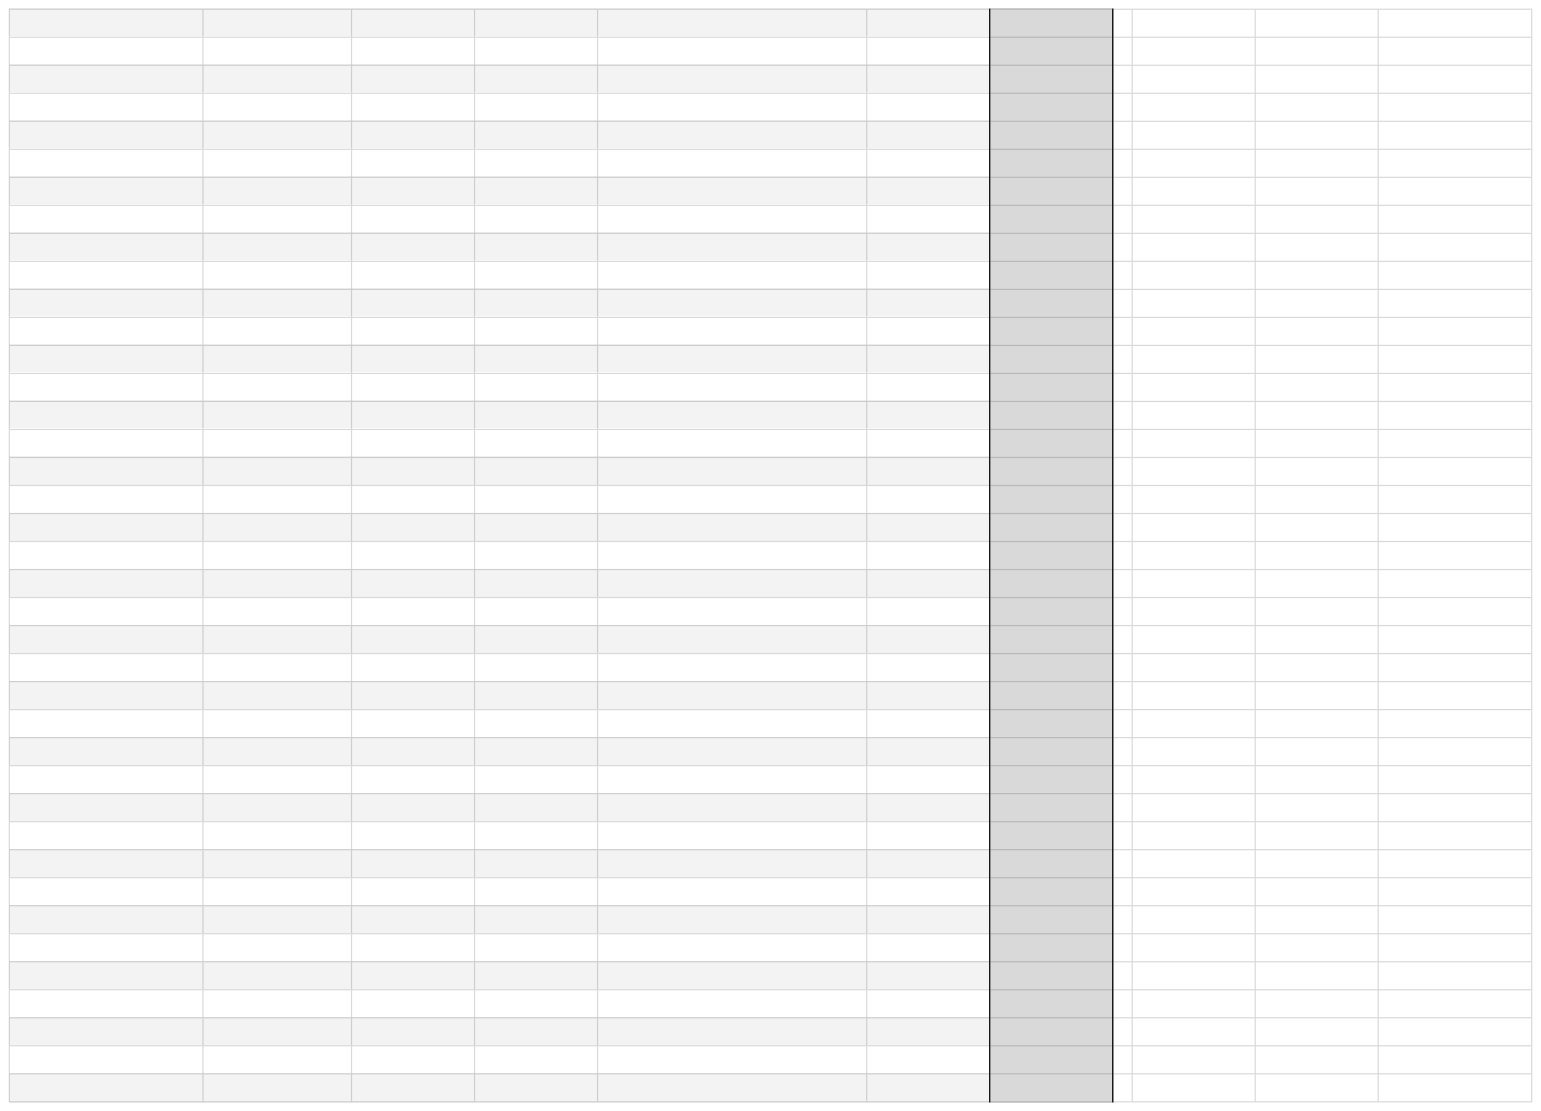
[picture p27: page 19]

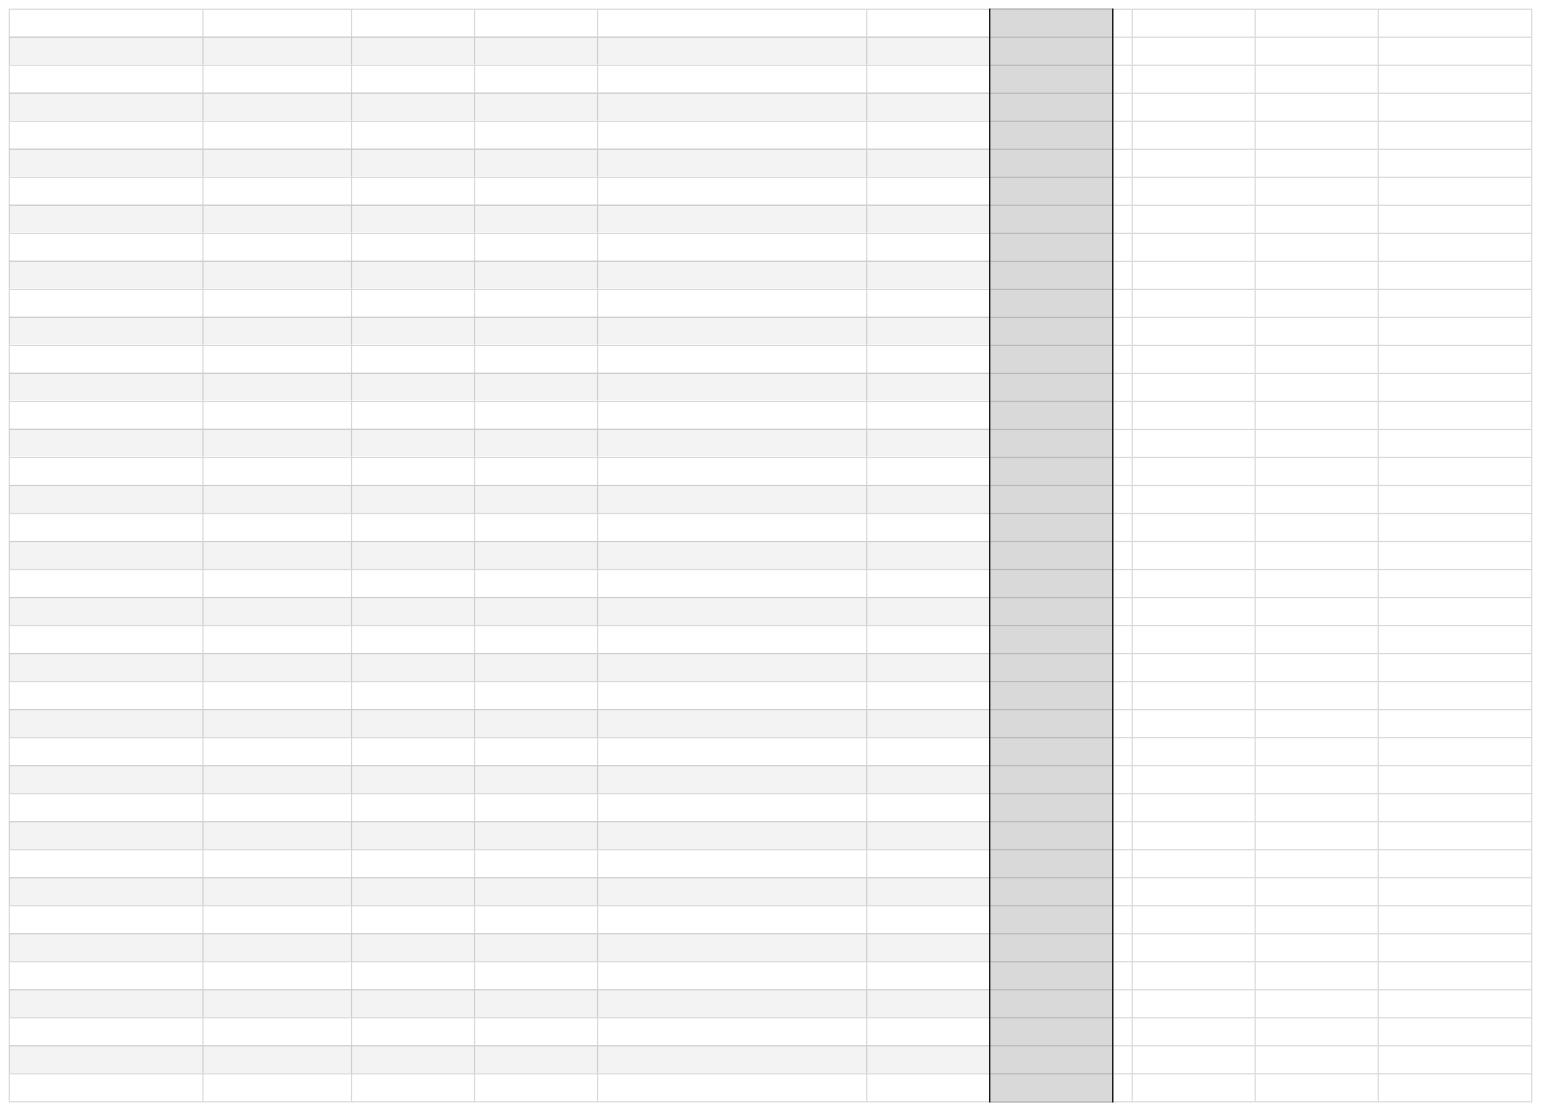
[picture p28: page 20]

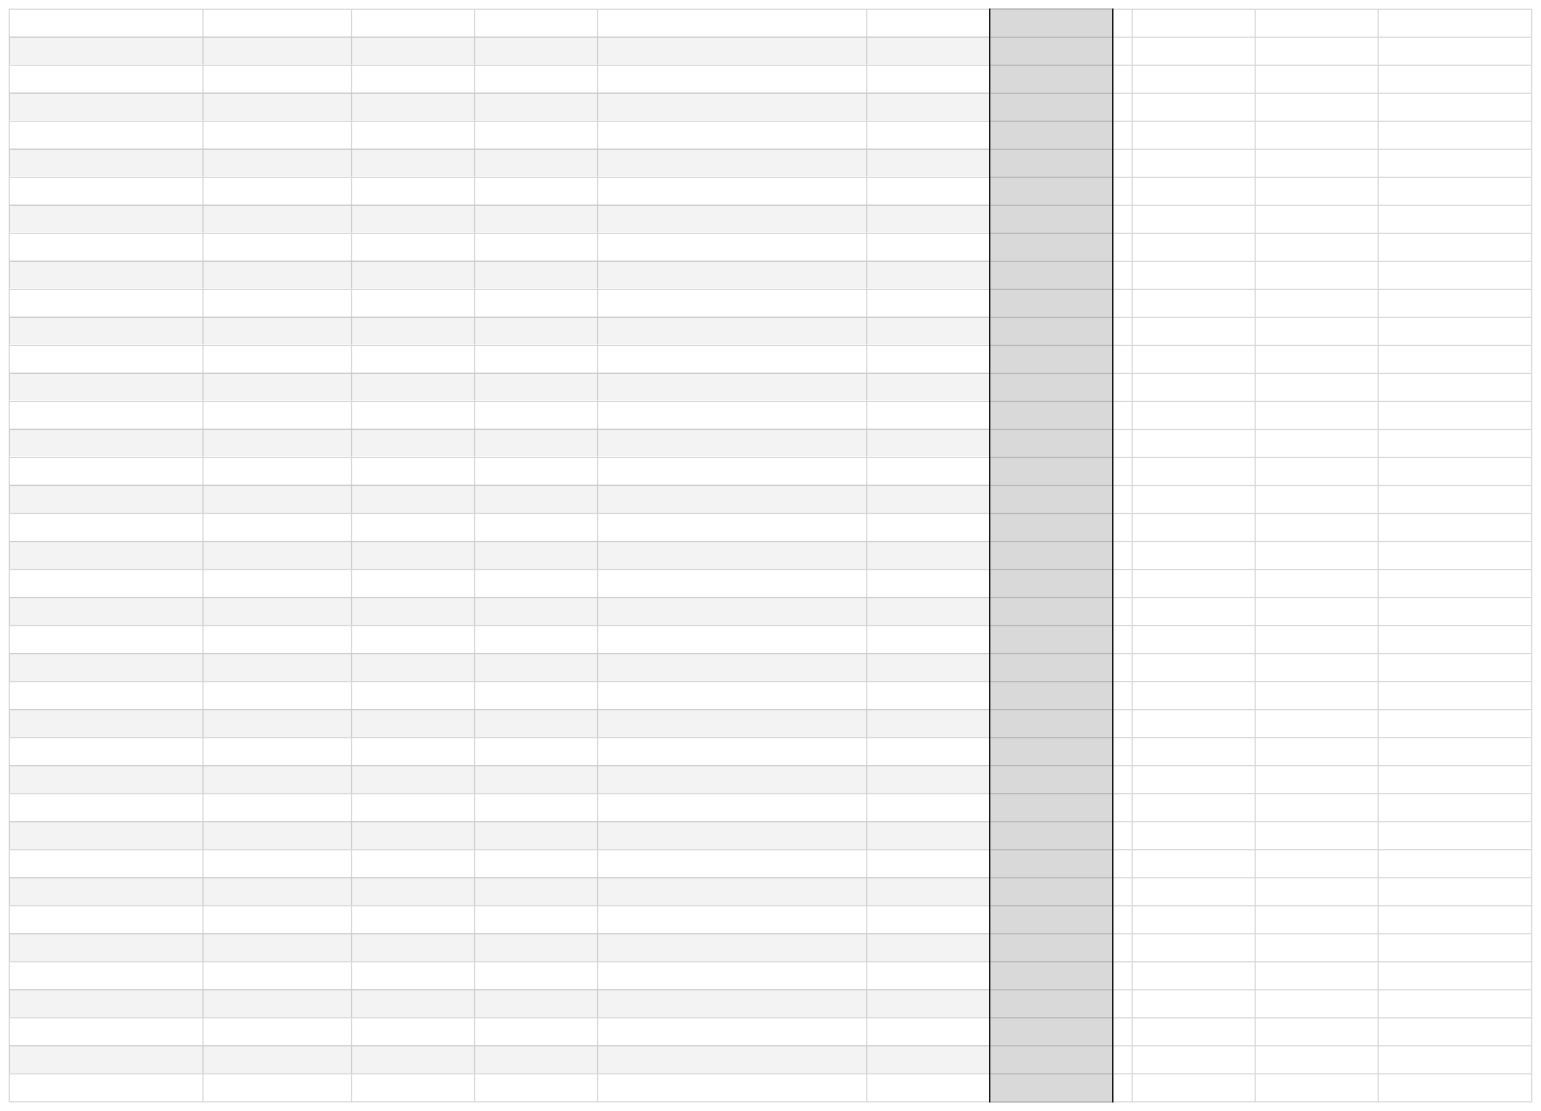
[picture p29: page 22]

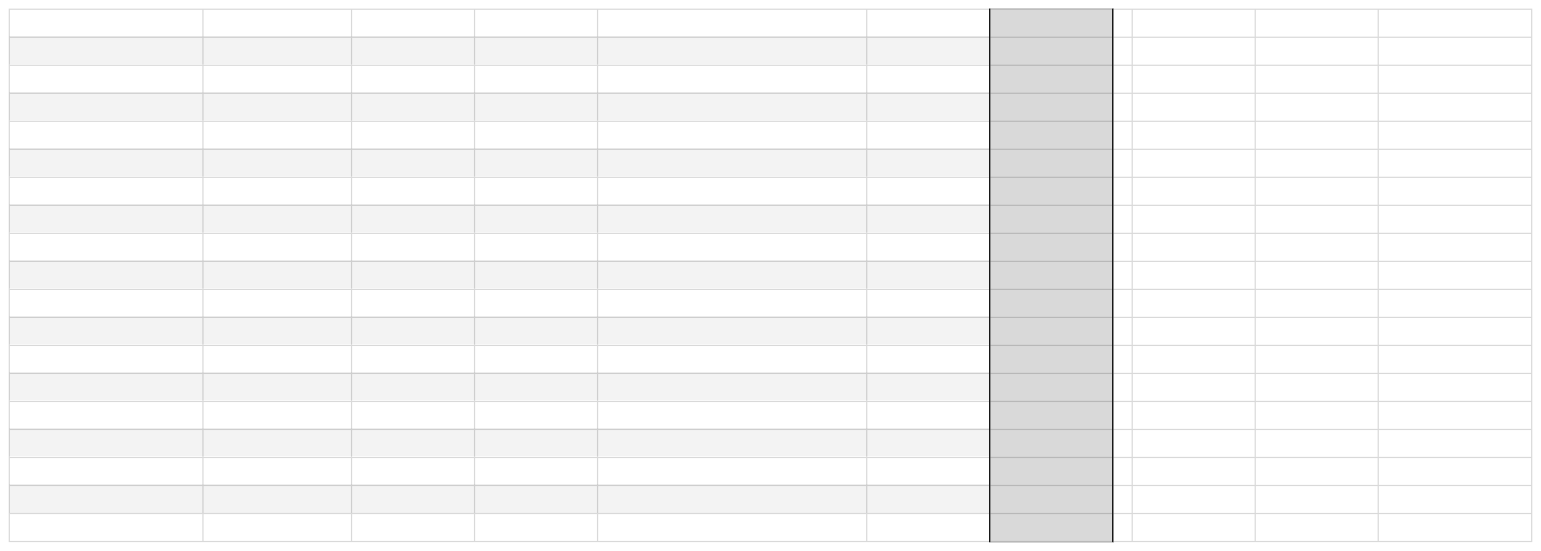
[picture p30: page 26]
