andrewgond/DIY-Oscilliscope/Oscilloscope-Project-Presentation.pdf

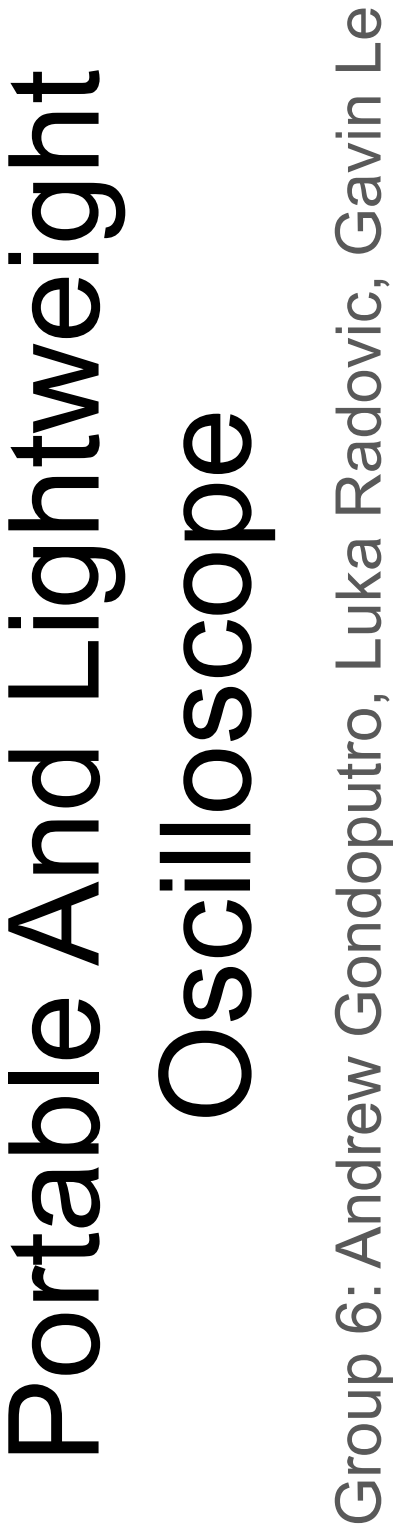
[picture p31: page 1]

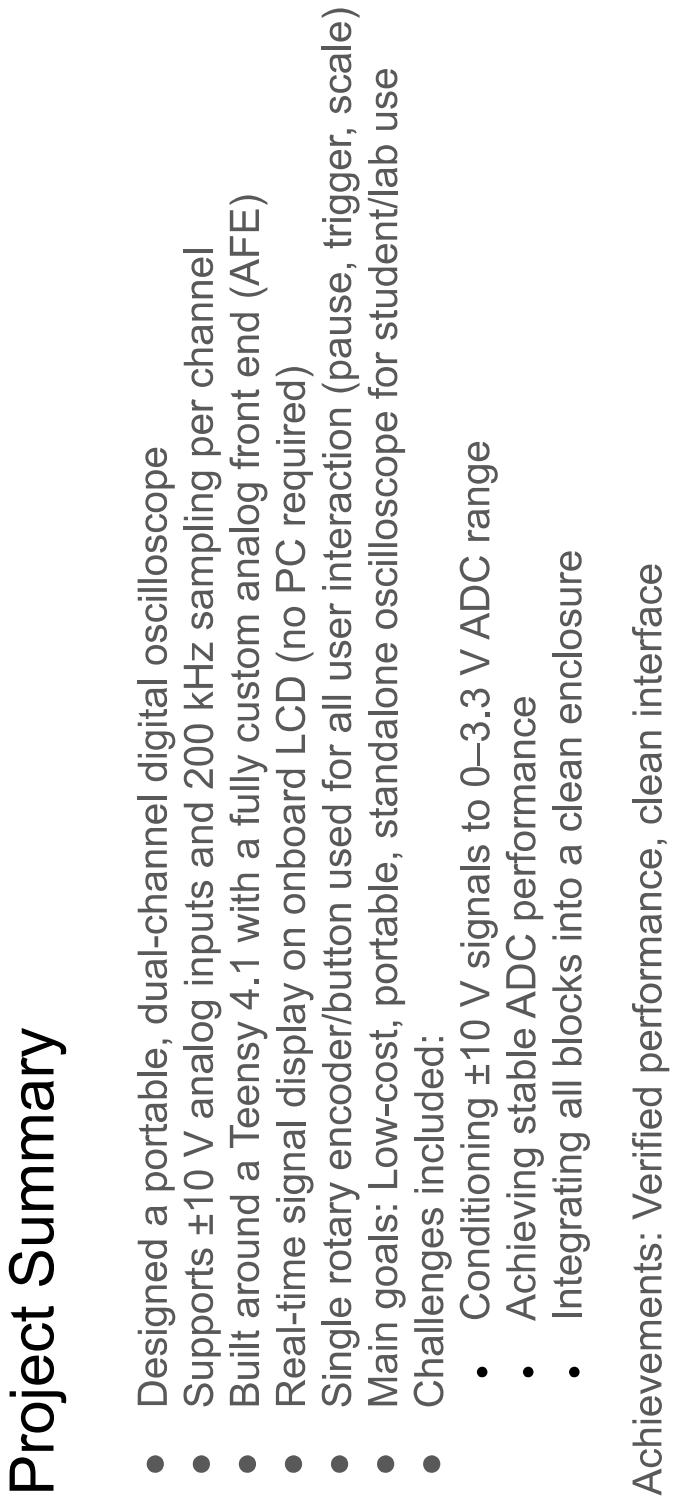
[picture p32: page 2]

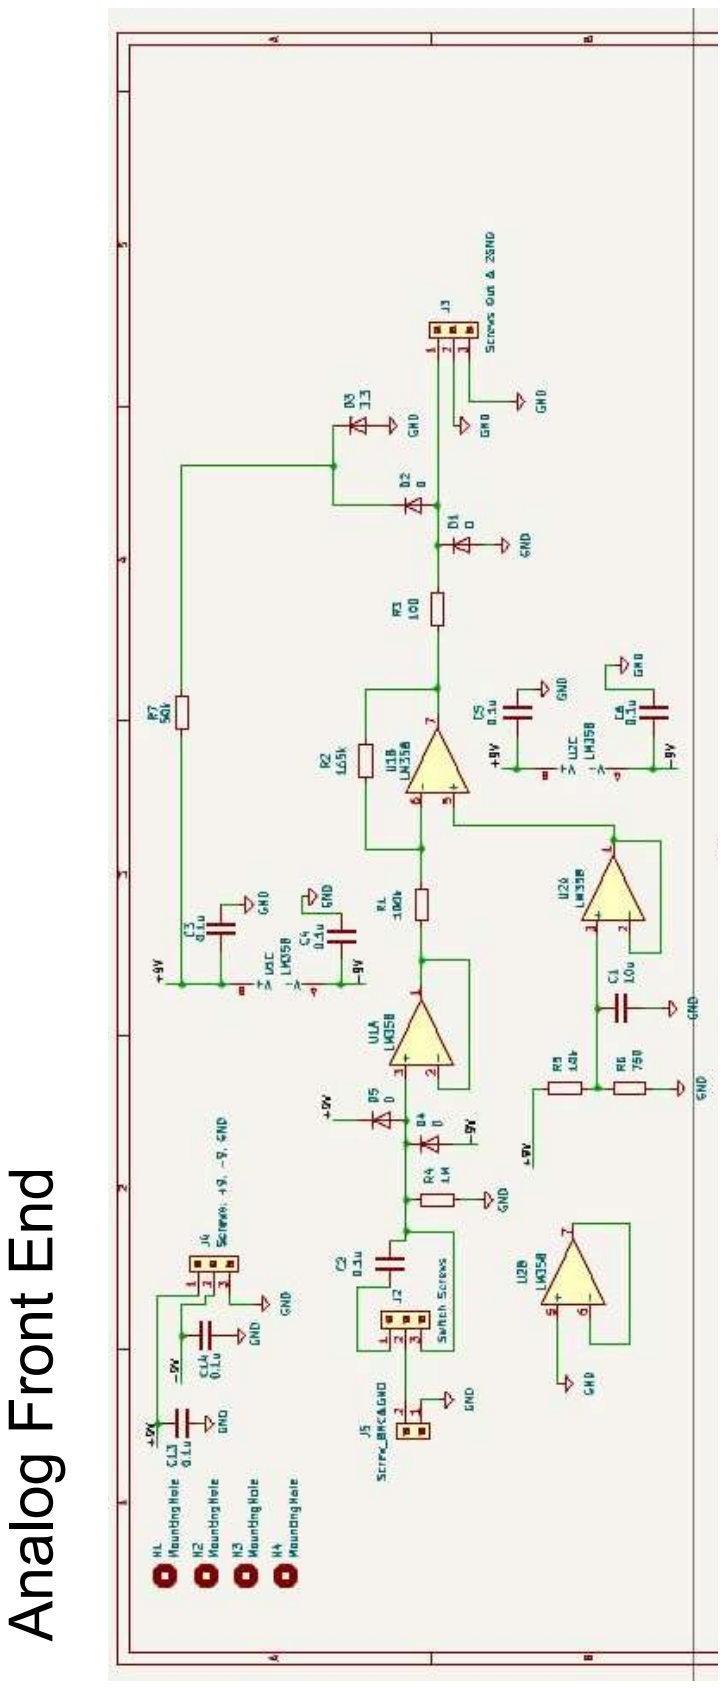
[picture p33: page 3]

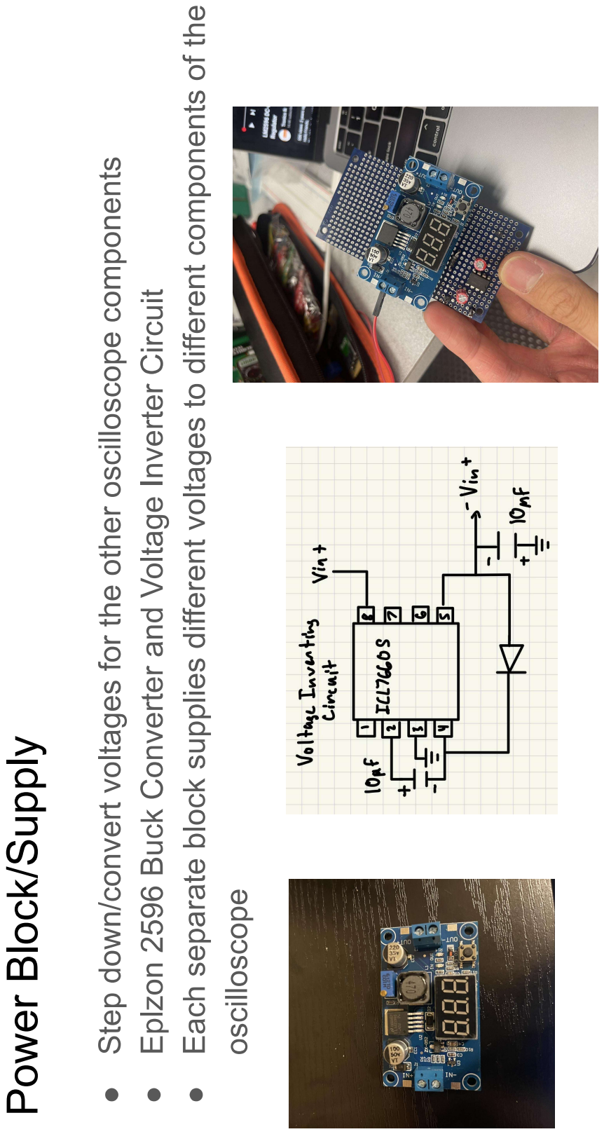
[picture p34: page 5]

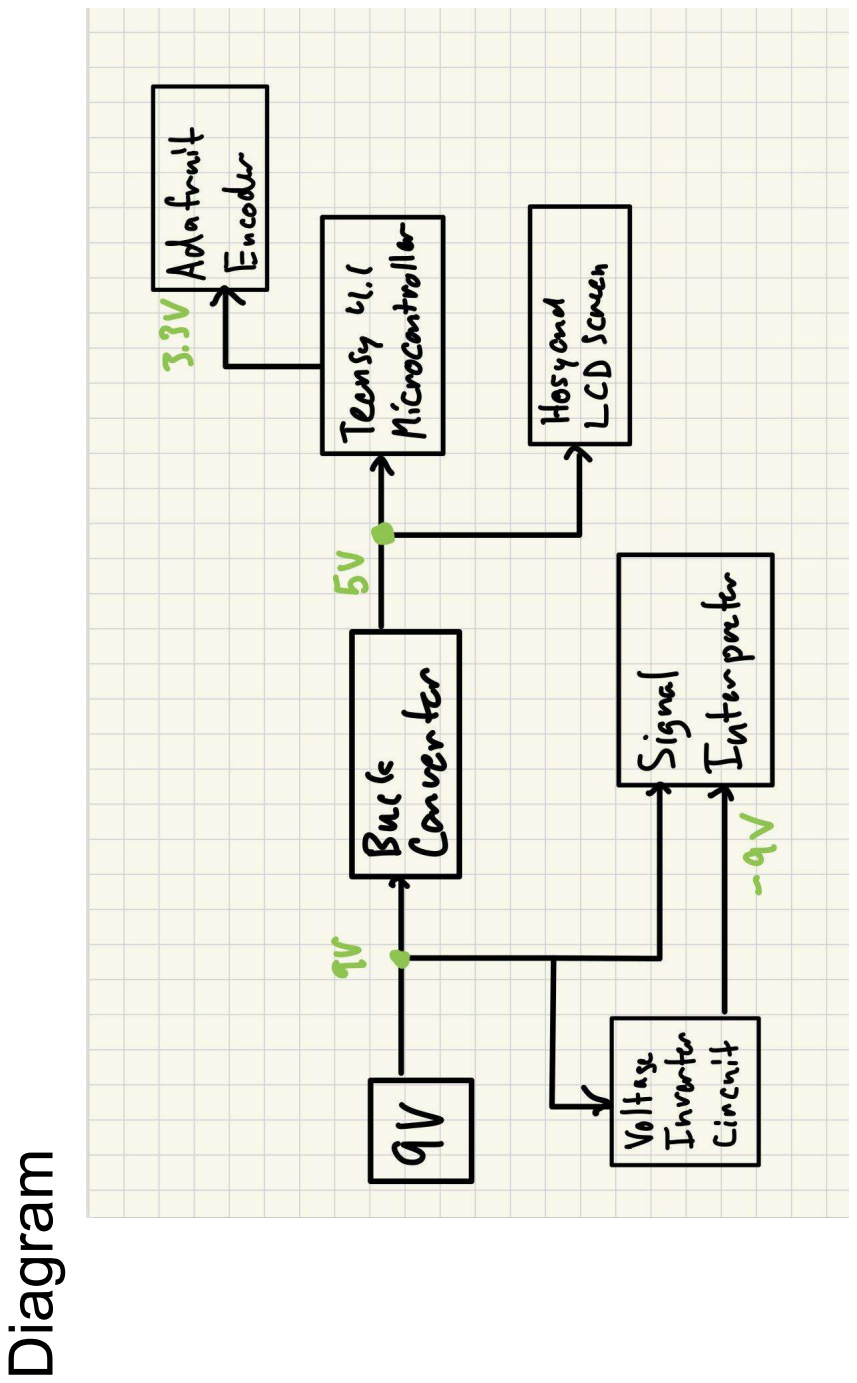
[picture p35: page 6]

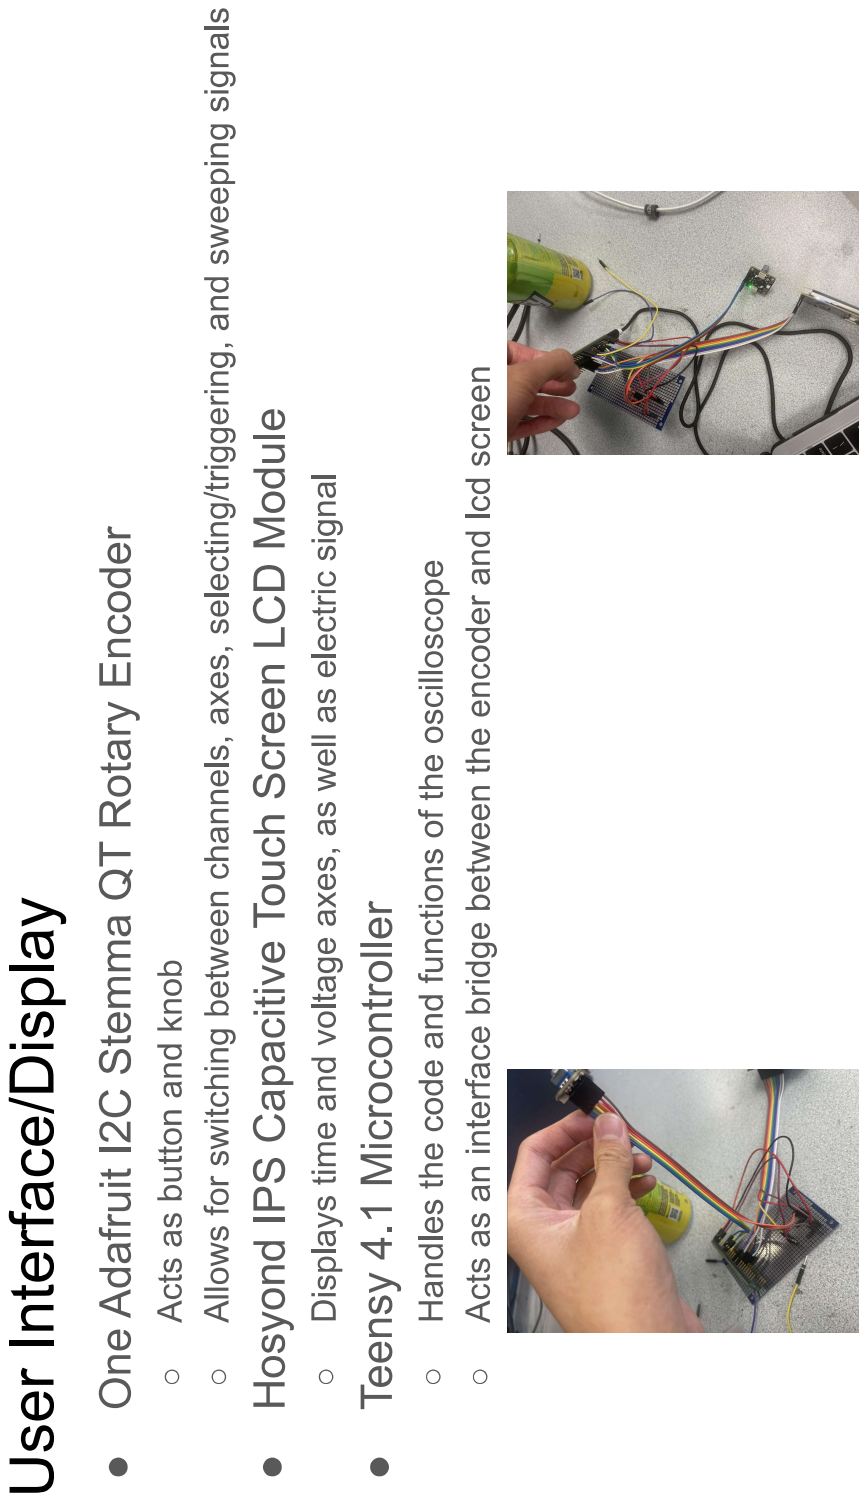
[picture p36: page 7]

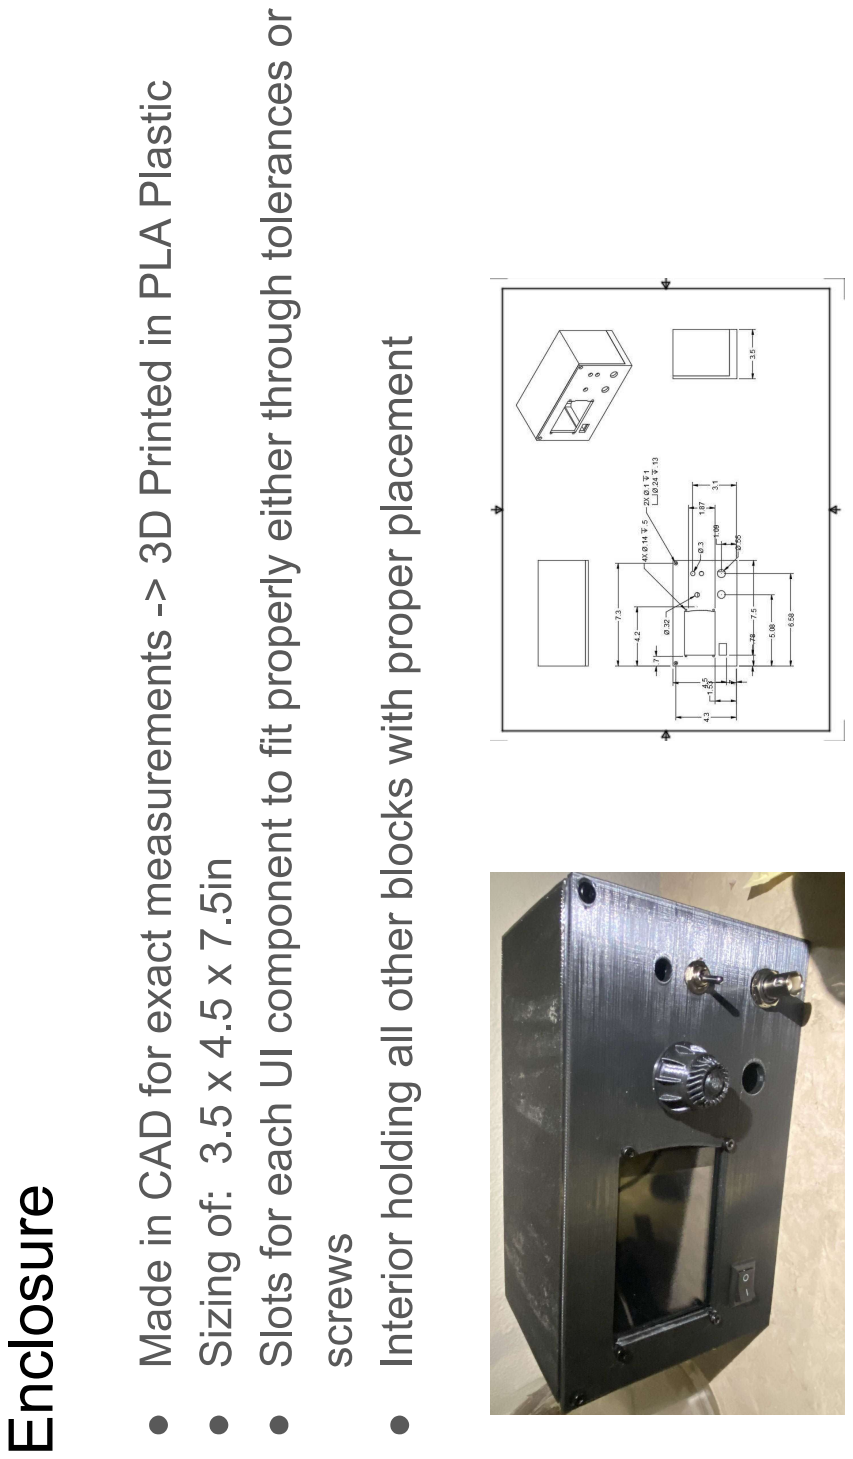
[picture p37: page 8]

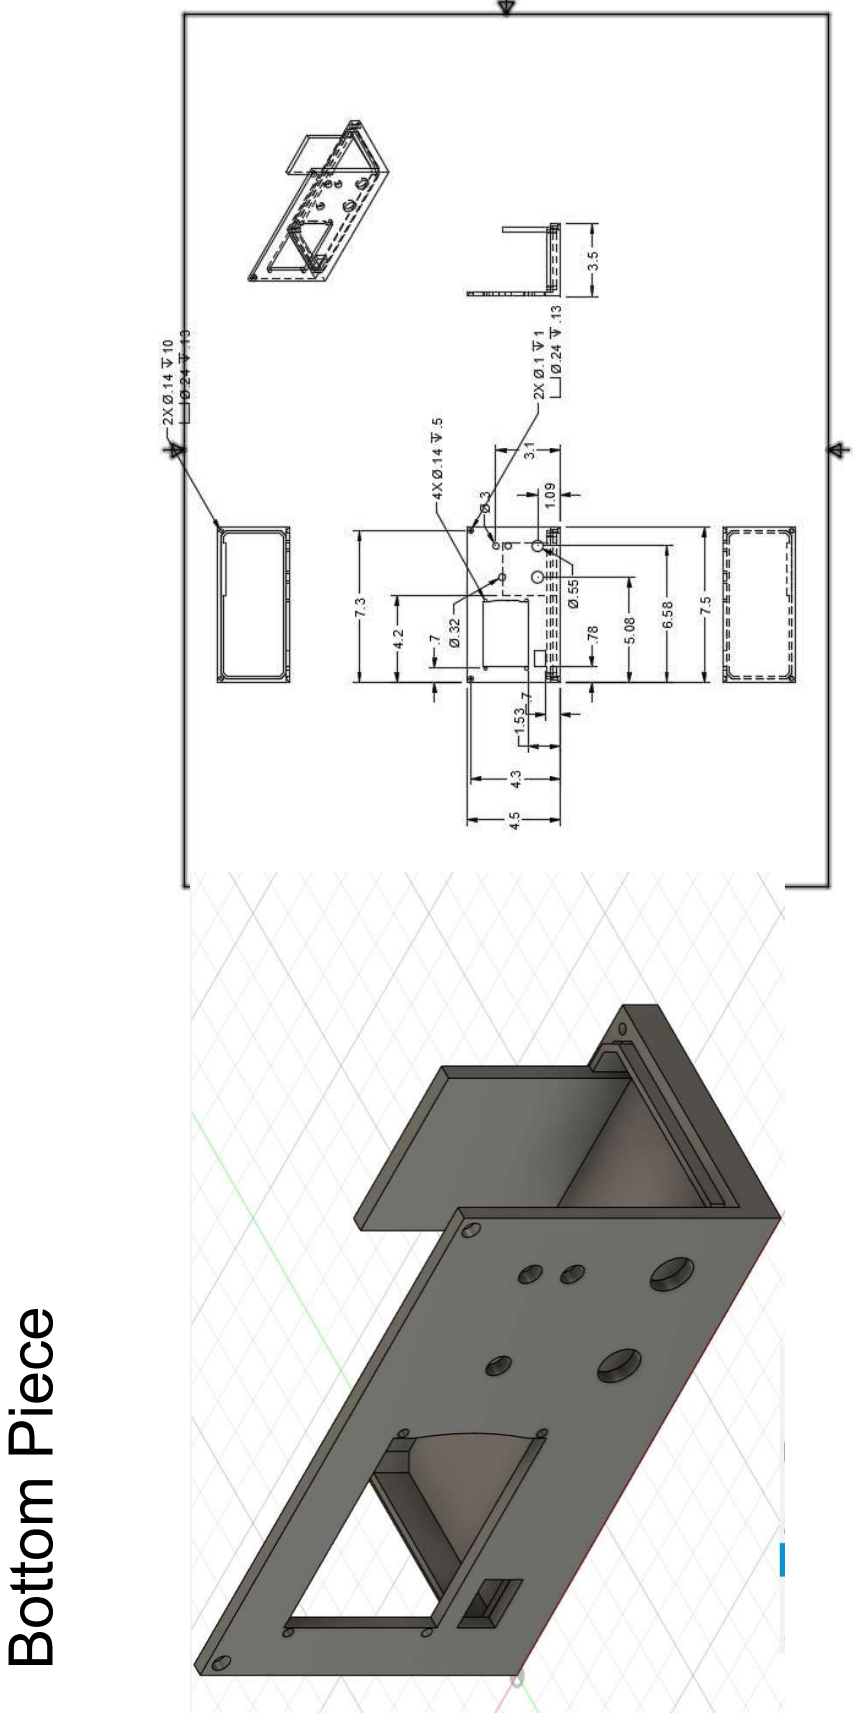
[picture p38: page 9]

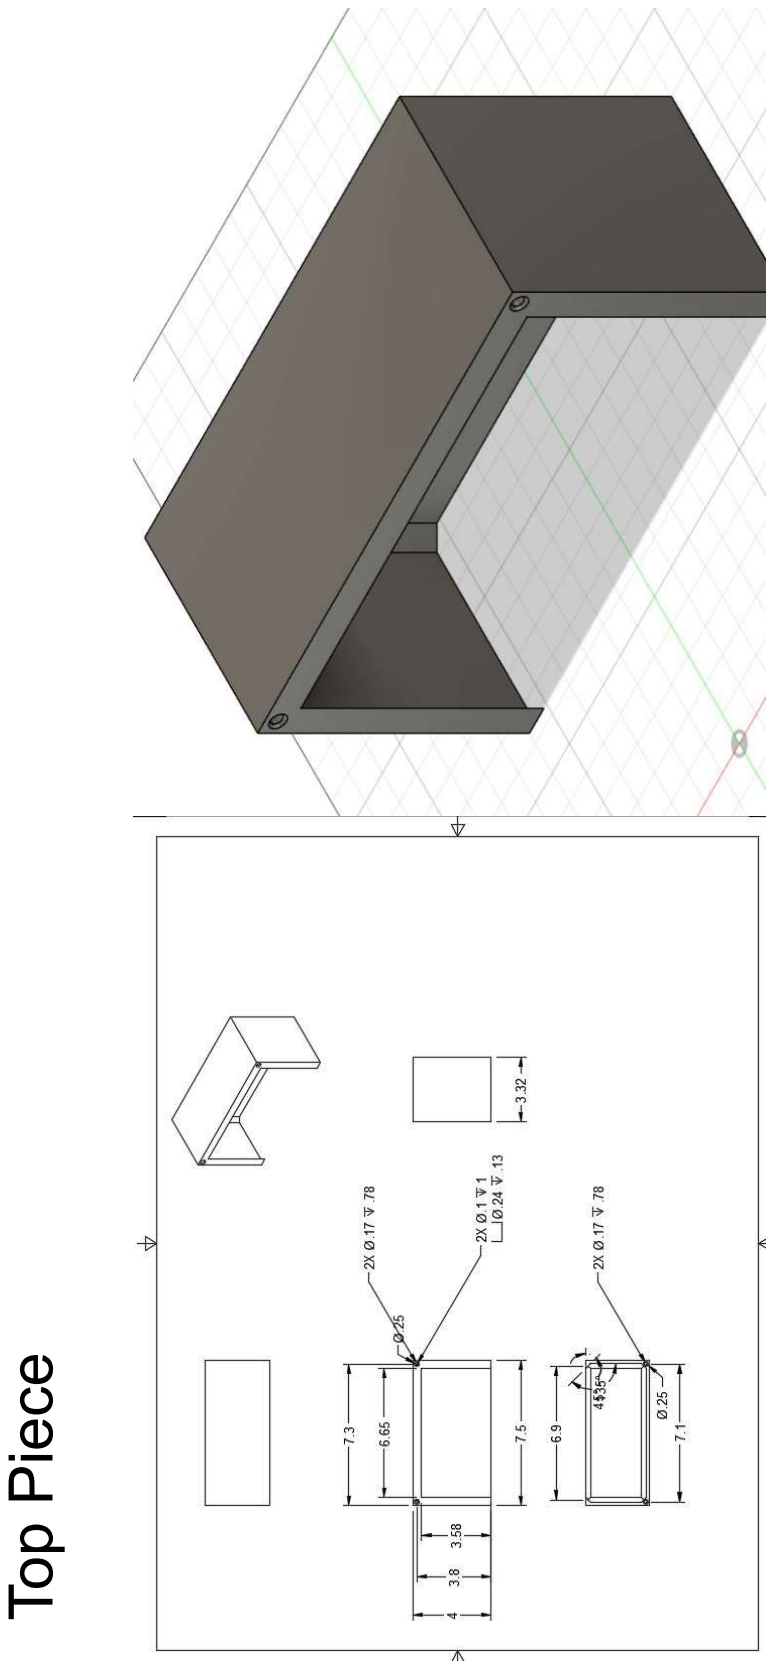
[picture p39: page 10]

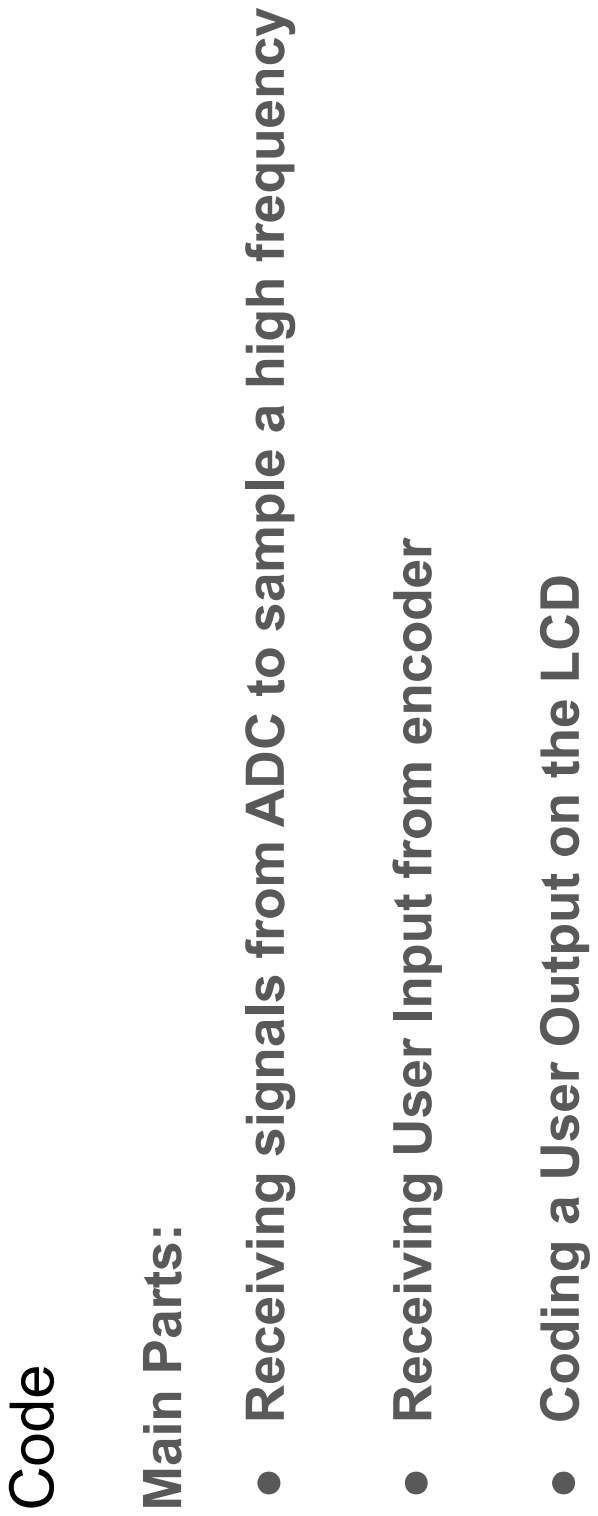
[picture p40: page 11]

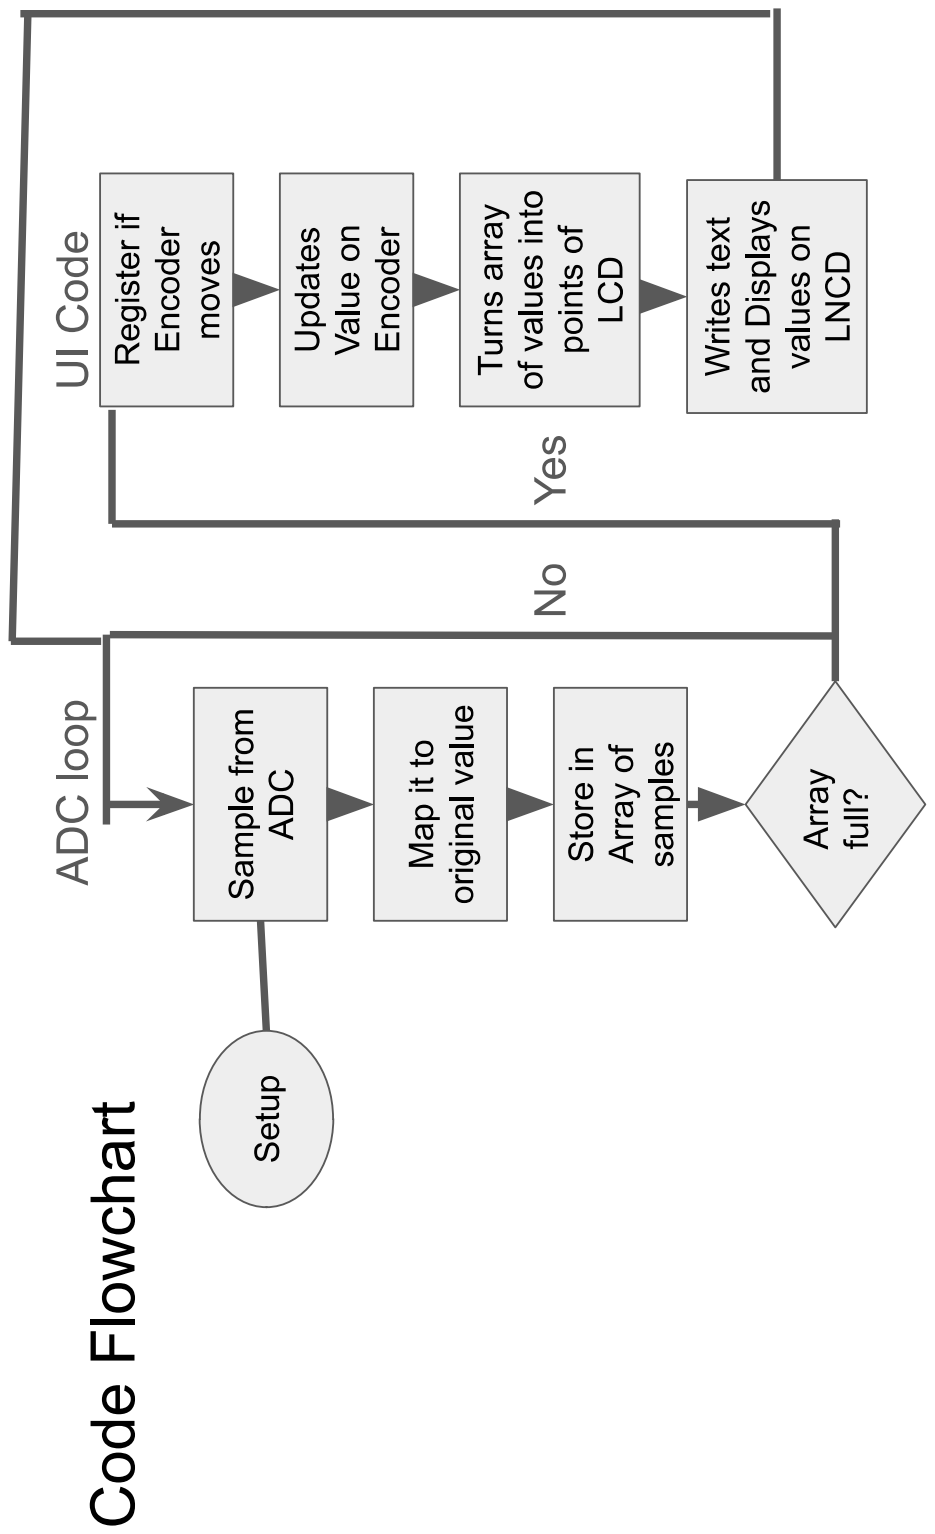
[picture p41: page 12]

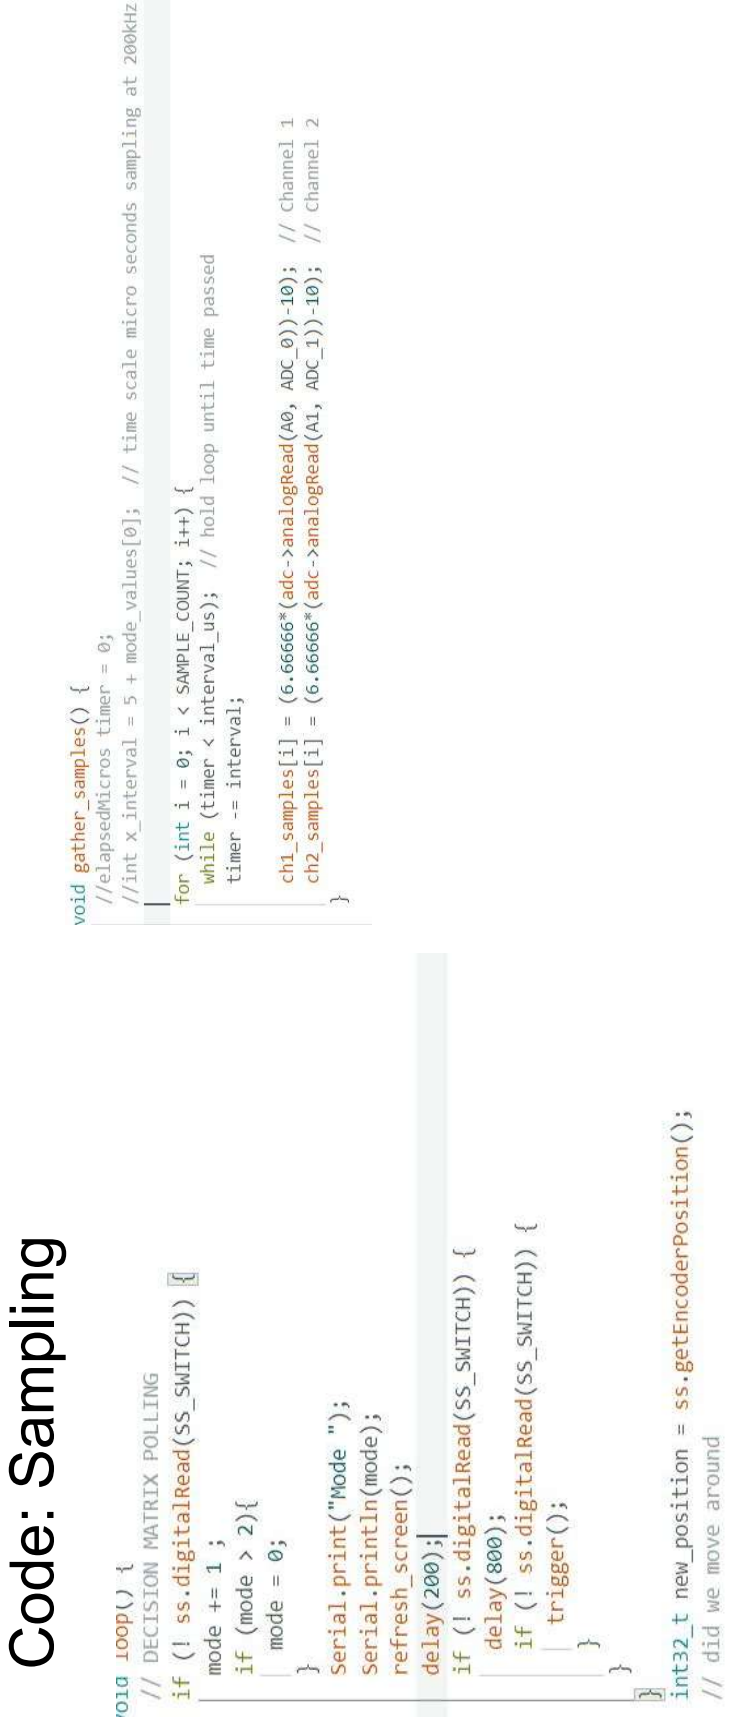
[picture p42: page 13]

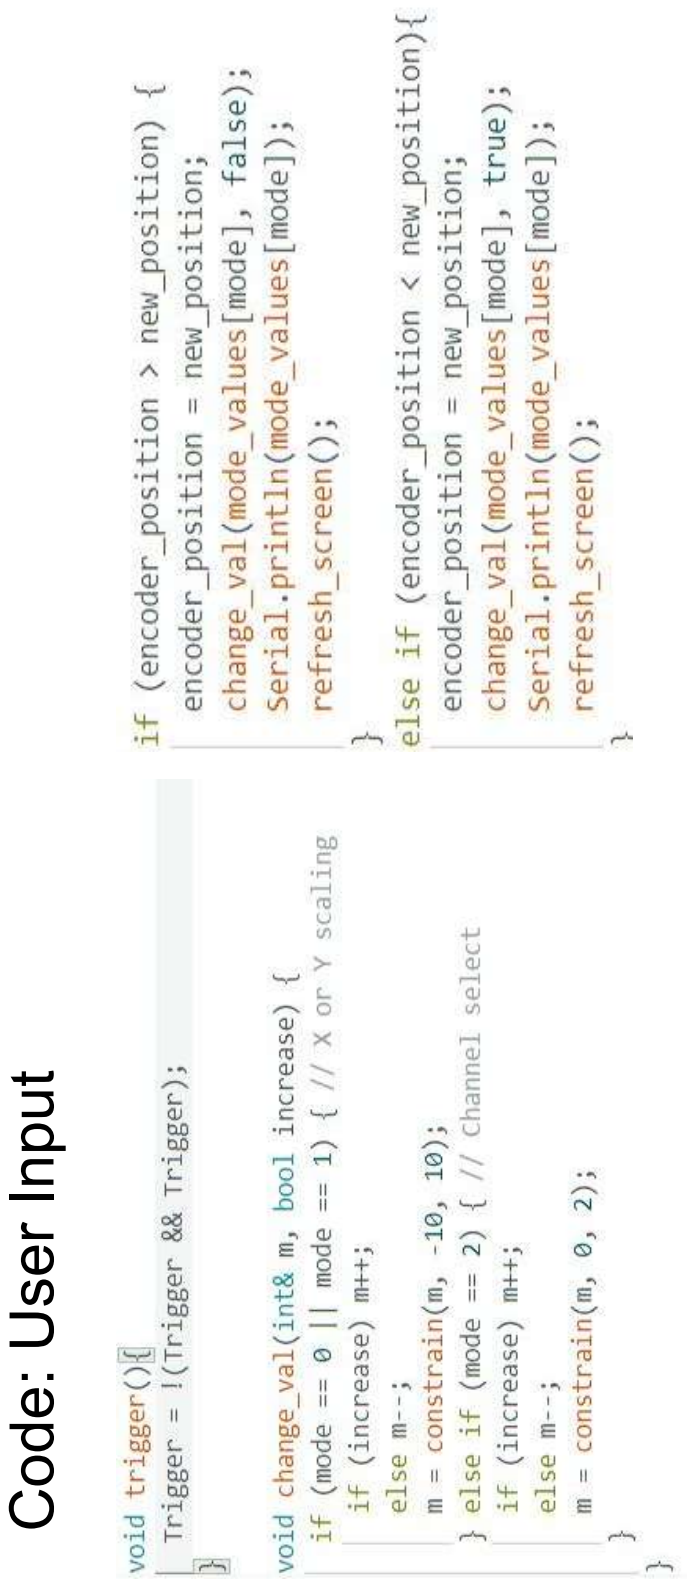
[picture p43: page 14]

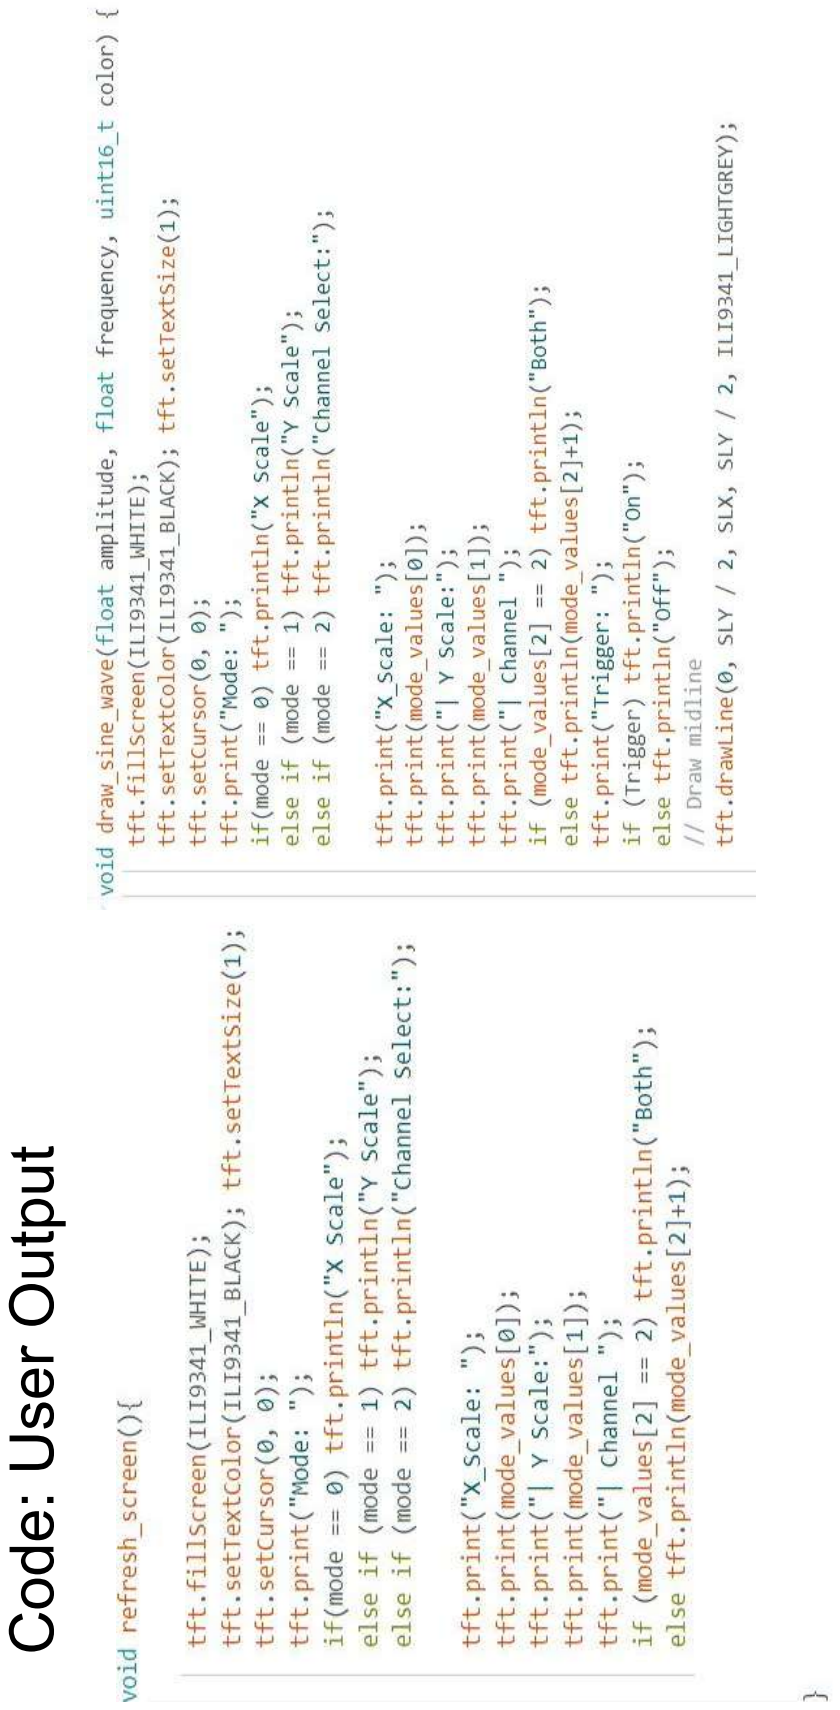
[picture p44: page 15]

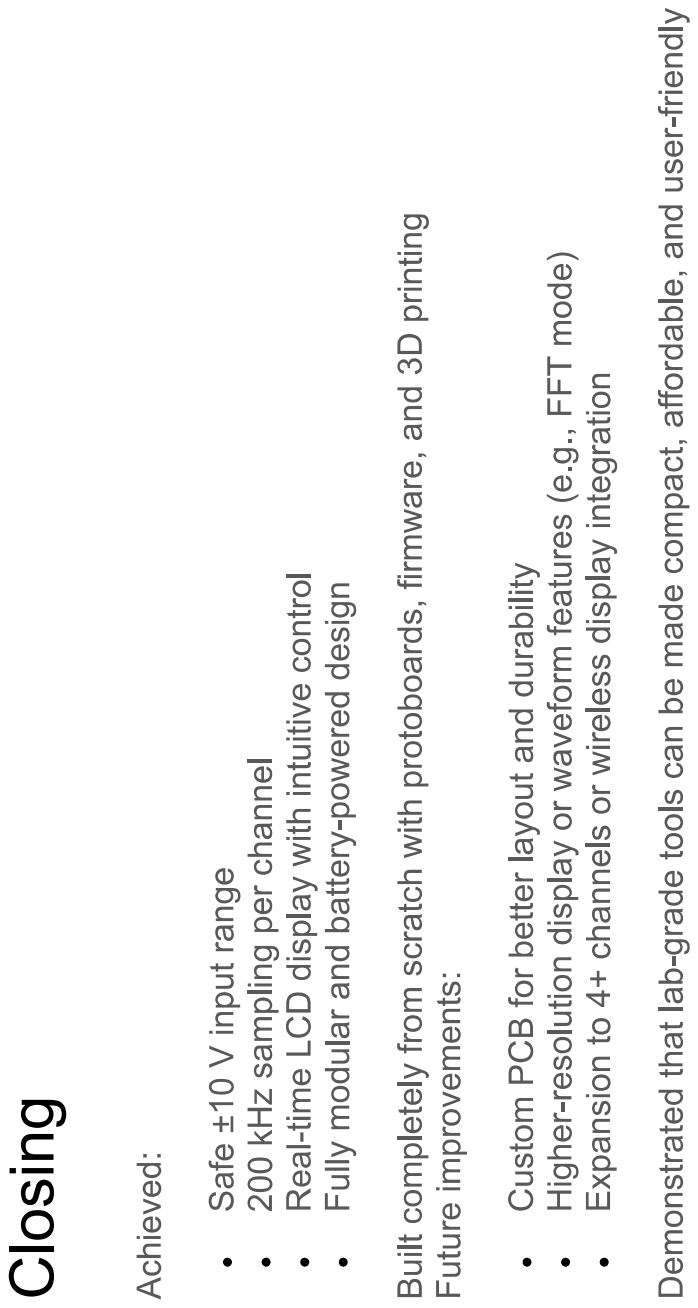
[picture p45: page 16]
