andrewgond/DIY-Oscilliscope/AFESchematic.kicad_pcb

## KiCad design AFESchematic.kicad_pcb (2025-11-24)

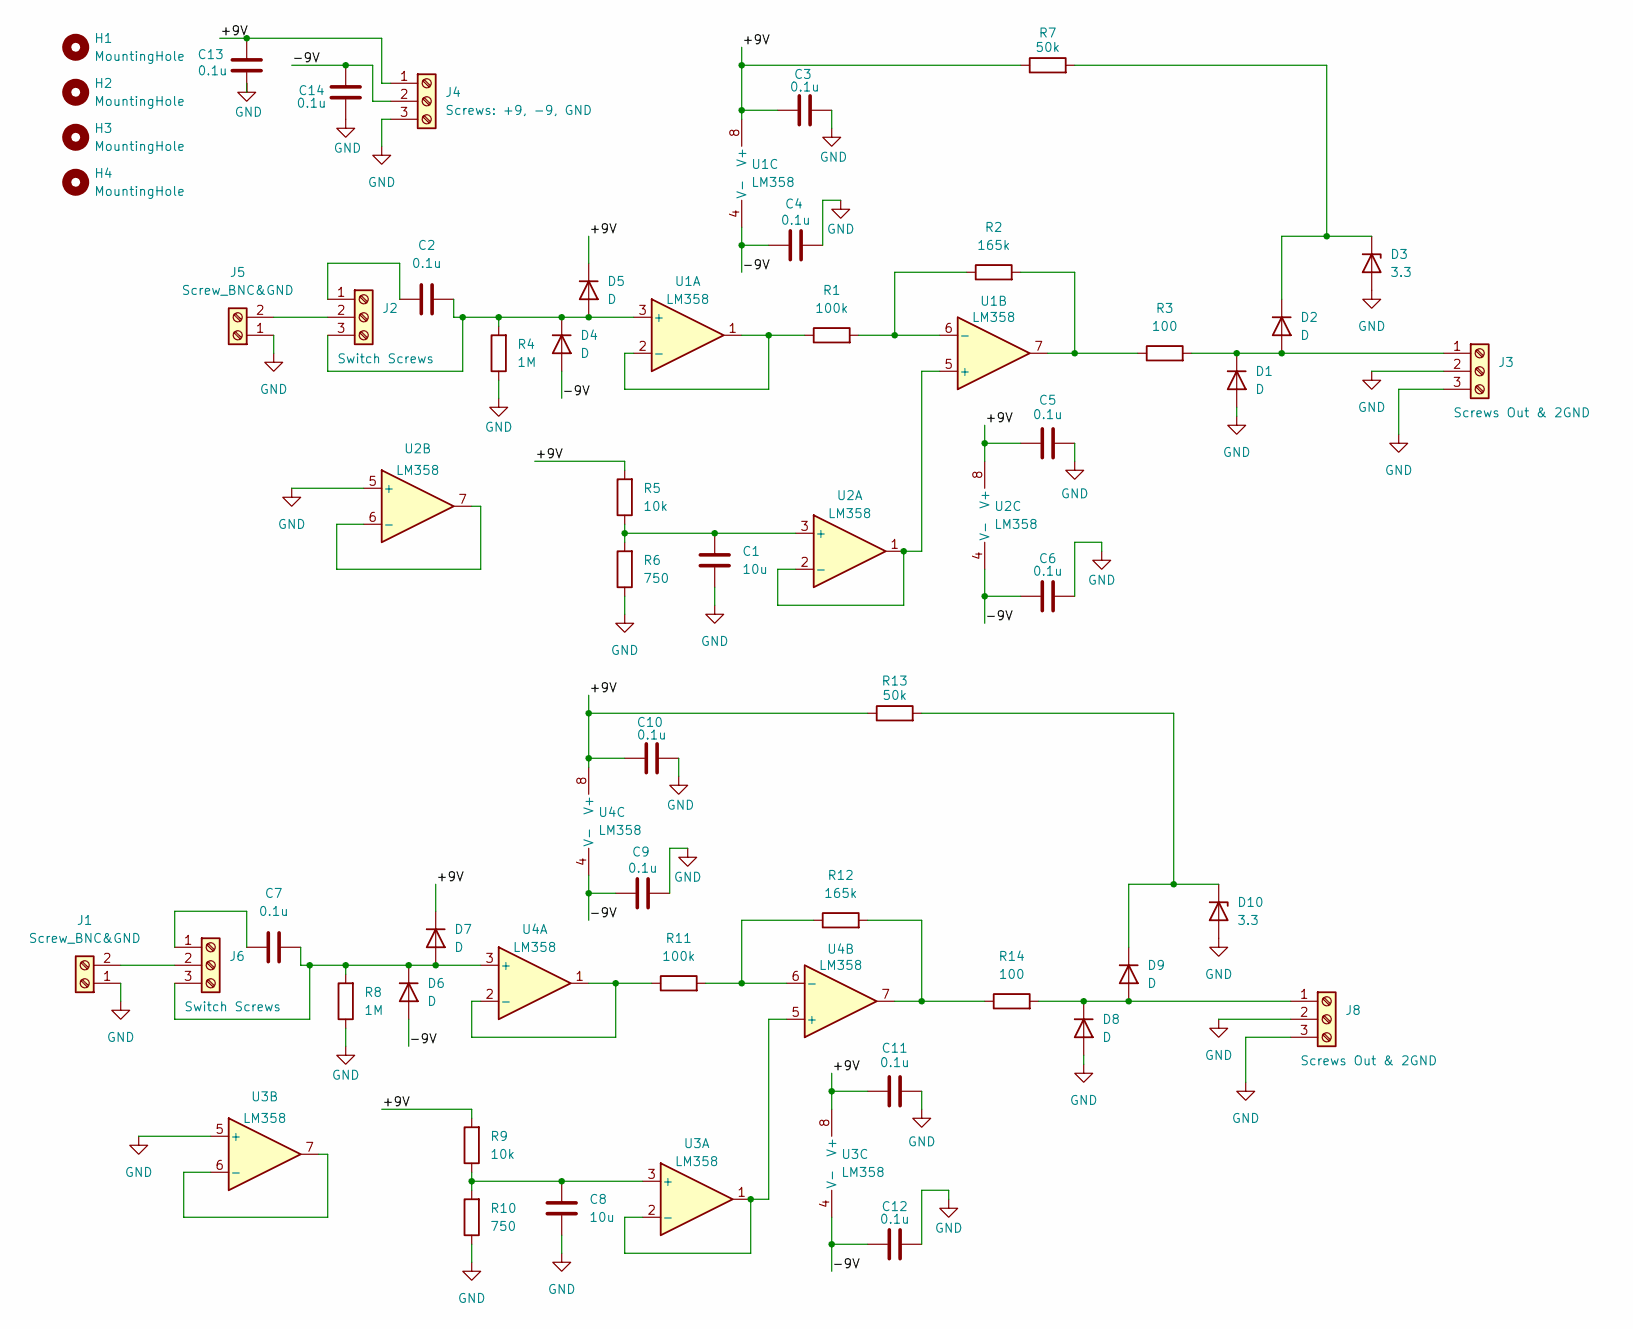
[picture p62: schematic AFESchematic.kicad_sch, Oscilloscope Analog Front End]

Parts:
C1, C8: 10u; C_0603_1608Metric
C2, C3, C4, C5, C6, C7, C9, C10, C11, C12, C13, C14: 0.1u; C_0603_1608Metric
D1, D2, D4, D5, D6, D7, D8, D9: D; D_SOD-523
D3, D10: 3.3; D_SOD-123
H1, H2, H3, H4: MountingHole; MountingHole_2.1mm
J1, J5: Screw_BNC&GND; 2ScrewTerm
J2, J6: Switch Screws; 3ScrewTerm
J3, J8: Screws Out & 2GND; 3ScrewTerm
J4: Screws: +9, -9, GND; 3ScrewTerm
R1, R11: 100k; R_0603_1608Metric
R2, R12: 165k; R_0603_1608Metric
R3, R14: 100; R_0603_1608Metric
R4, R8: 1M; R_0603_1608Metric
R5, R9: 10k; R_0603_1608Metric
R6, R10: 750; R_0603_1608Metric
R7, R13: 50k; R_0603_1608Metric
U1, U2, U3, U4: LM358; SOIC127P599X175-8N

Connections:
/+9V: C3.2, C5.2, C10.2, C11.2, C13.2, D5.1 (K), D7.1 (K), J4.1, R5.2, R7.1, R9.2, R13.1, U1.8 (V+), U2.8 (V+), U3.8 (V+), U4.8 (V+)
/-9V: C4.2, C6.2, C9.2, C12.2, C14.2, D4.2 (A), D6.2 (A), J4.2, U1.4 (V-), U2.4 (V-), U3.4 (V-), U4.4 (V-)
GND: C1.1, C3.1, C4.1, C5.1, C6.1, C8.1, C9.1, C10.1, C11.1, C12.1, C13.1, C14.1, D1.2 (A), D3.2 (A), D8.2 (A), D10.2 (A), J1.1, J3.2, J3.3, J4.3, J5.1, J8.2, J8.3, R4.1, R6.1, R8.1, R10.1, U2.5 (+), U3.5 (+)
unnamed: D1.1 (K), D2.2 (A), J3.1, R3.2
unnamed: D2.1 (K), D3.1 (K), R7.2
unnamed: C2.1, D4.1 (K), D5.2 (A), J2.3, R4.2, U1.3 (+)
unnamed: C7.1, D6.1 (K), D7.2 (A), J6.3, R8.2, U4.3 (+)
unnamed: D8.1 (K), D9.2 (A), J8.1, R14.2
unnamed: D9.1 (K), D10.1 (K), R13.2
unnamed: J1.2, J6.2
unnamed: C2.2, J2.1
unnamed: J2.2, J5.2
unnamed: C7.2, J6.1
unnamed: R2.2, R3.1, U1.7
unnamed: R12.2, R14.1, U4.7
unnamed: R1.1, U1.1, U1.2 (-)
unnamed: U1.5 (+), U2.1, U2.2 (-)
unnamed: R1.2, R2.1, U1.6 (-)
unnamed: C1.2, R5.1, R6.2, U2.3 (+)
unnamed: U2.6 (-), U2.7
unnamed: C8.2, R9.1, R10.2, U3.3 (+)
unnamed: U3.1, U3.2 (-), U4.5 (+)
unnamed: U3.6 (-), U3.7
unnamed: R11.1, U4.1, U4.2 (-)
unnamed: R11.2, R12.1, U4.6 (-)

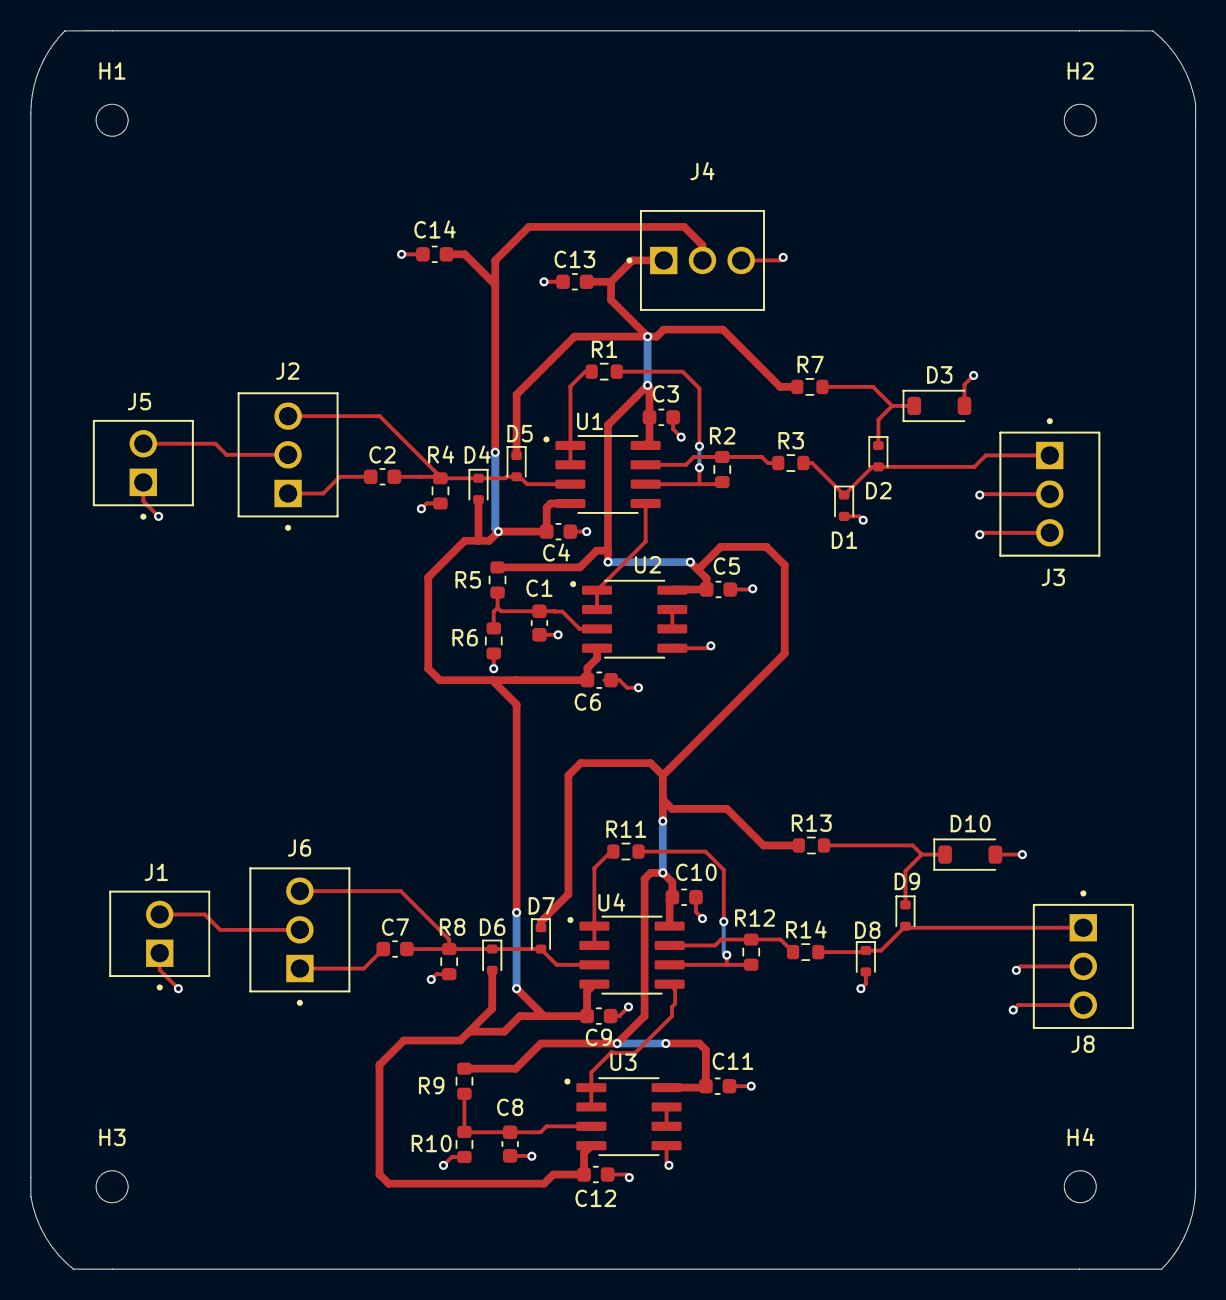
[picture p63: board AFESchematic.kicad_pcb from above]

Board: 2 copper layers, 76.5 x 81.3 mm, 53 parts (0 on the bottom side), 25 nets.
